Faaz17/nurdle-dna/jetson/README.md

# NurdleDNA — Jetson Nano Agent

Runs on the NVIDIA Jetson Nano. Handles AI vision, serial comms with the Arduino, and Firebase cloud publishing.

---

## 1. First-time setup

```bash
# Clone repo on Jetson
git clone https://github.com/Faaz17/nurdle-dna.git
cd nurdle-dna/jetson
```

### Jetson Nano (original — 4GB)
The standard Ultralytics/torch stack does NOT install cleanly on Jetson Nano.
Use the lightweight install instead:

```bash
pip3 install pyrebase4 pyserial opencv-python onnxruntime
```

The vision module will use the ONNX model if present (fast), or fall back
to the built-in OpenCV HSV detector (no model needed).

### Jetson Orin / desktop / cloud
```bash
pip3 install -r requirements.txt
```

---

## 2. Configure

Edit `config.py`:

| Setting | What to change |
|---|---|
| `SERIAL_PORT` | Run `ls /dev/tty*` before and after plugging in USB → find the new entry (usually `/dev/ttyUSB0` or `/dev/ttyACM0`) |
| `CAMERA_INDEX` | `0` for USB webcam; for CSI cam use the GStreamer string from Jetson camera docs |
| `YOLO_MODEL` | Path to your `.onnx` model. Set `None` to use OpenCV fallback |
| `FIREBASE_CONFIG` | Paste values from Firebase Console → Project Settings → General → Web app |

---

## 3. YOLOv8 model (optional but recommended)

**Option A — Use Roboflow pre-trained nurdle model (fastest)**
```bash
pip3 install roboflow
python3 -c "
from roboflow import Roboflow
rf = Roboflow(api_key='YOUR_ROBOFLOW_KEY')
project = rf.workspace().project('nurdle-microplastic')
model = project.version(1).model
model.download('yolov8')
"
# Then export to ONNX:
yolo export model=nurdle-microplastic.pt format=onnx
mv nurdle-microplastic.onnx models/nurdle-yolov8n.onnx
```

**Option B — Skip model, use OpenCV fallback**
Set `YOLO_MODEL = None` in `config.py`. The HSV colour detector works without any model file.

---

## 4. Run

```bash
python3 main.py
```

Press `Ctrl+C` to stop cleanly.

---

## 5. Auto-start on Jetson boot (systemd)

For the prototype enclosure (no keyboard / monitor attached during normal
operation), the agent should start automatically when the Jetson powers on.
A ready-to-use unit file is shipped at [`nurdle-agent.service`](nurdle-agent.service).

One-time install:

```bash
cd ~/nurdle-dna && git pull
sudo cp jetson/nurdle-agent.service /etc/systemd/system/
sudo systemctl daemon-reload
sudo systemctl enable --now nurdle-agent.service
```

Check it's running:

```bash
sudo systemctl status nurdle-agent.service
journalctl -u nurdle-agent -n 50    # last 50 log lines
```

The full guide — including diagnostics, what to expect at power-on, and how
to monitor status without a screen — is in
[INSTALL_AUTOSTART.md](INSTALL_AUTOSTART.md).

---

## 6. Data flow

```
Camera
  → vision.py (YOLOv8n / HSV)
      → count, confidence, state (CLEAR / WARN / CRIT)
          → serial_bridge.py → Arduino (JSON command)
          → cloud.py → Firebase /devices/NURDLE-001
                     → Firebase /events/{key}  (on ALARM)
Arduino
  → serial_bridge.py (JSON telemetry every 200 ms)
      → cloud.py (merged into Firebase payload)
```

---

## 7. Firebase database structure

```json
/devices/NURDLE-001 {
  "timestamp":     "2026-05-11T10:32:00Z",
  "device_id":     "NURDLE-001",
  "bay_id":        "BAY-1",
  "fsm_state":     "S3",
  "valve":         "CLOSED",
  "ldr":           642,
  "gas_ppm":       380,
  "load_g":        3.4,
  "density_index": 72,
  "status":        "ALARM",
  "ai_state":      "CRIT",
  "ai_count":      12,
  "ai_confidence": 0.87
}

/events/{push-key} {
  "timestamp":     "2026-05-11T10:32:00Z",
  "device_id":     "NURDLE-001",
  "type":          "ALARM",
  "fsm_state":     "S3",
  "density_index": 84,
  "gas_ppm":       380,
  "load_g":        3.4,
  "ai_count":      12
}
```
