Faaz17/nurdle-dna/Presentations/ICSIMA2026_Video_Package/ICSIMA2026_NurdleDNA_Video_Presentation.pptx

ICSIMA2026

NurdleDNA: An Edge-AI and Smart IoT Inline System for Source-Level Microplastic Detection

Faaz Ali Sayyed, Muhammad Haaziq, Daniel Joseph Koshy, Mohammed Abdul Rehman, Syed Hasan Ali, Razveen Kashif, and Mohd Fareq Abd Malek

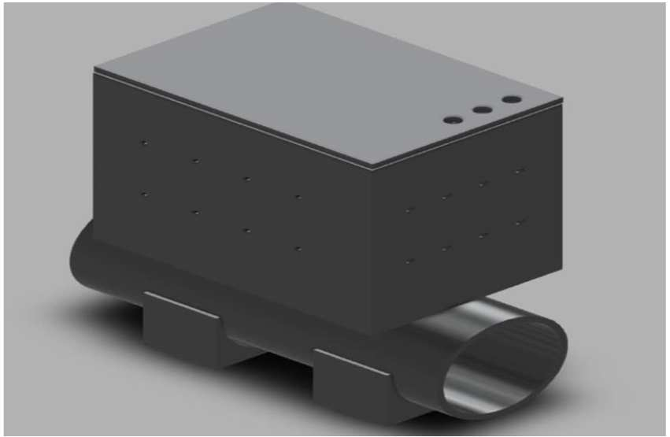
[picture p3: figure]
CAD rendering of the NurdleDNA inline device

University of Wollongong in Dubai

Backup presentation video: 12 minutes maximum, followed by live Q&A

ICSIMA2026 backup video | NurdleDNA

1 / 12

## Slide 2

Industrial nurdle leaks need source-level response

The problem is not only detecting pellets. It is intercepting them before they leave the discharge point.

3-5 mm

typical pre-production pellet size

Real time

required before downstream spread

Source level

where containment still works

Core gap

Existing approaches can often detect or document contamination, but they do not physically arrest the flow and preserve an audit trail at the source.

NurdleDNA targets that gap.

- Manual inspection and passive filters are too slow for active discharge streams
- Turbidity or particle counters confuse nurdles with bubbles, sand, and bio-particles
- Laboratory FTIR and Raman methods are accurate, but not inline containment systems
- Industrial drains may also carry VOC or hydrocarbon contamination

ICSIMA2026 backup video | NurdleDNA

2 / 12

## Slide 3

NurdleDNA closes the loop from detection to evidence

The system couples AI perception with deterministic actuation and cloud logging.

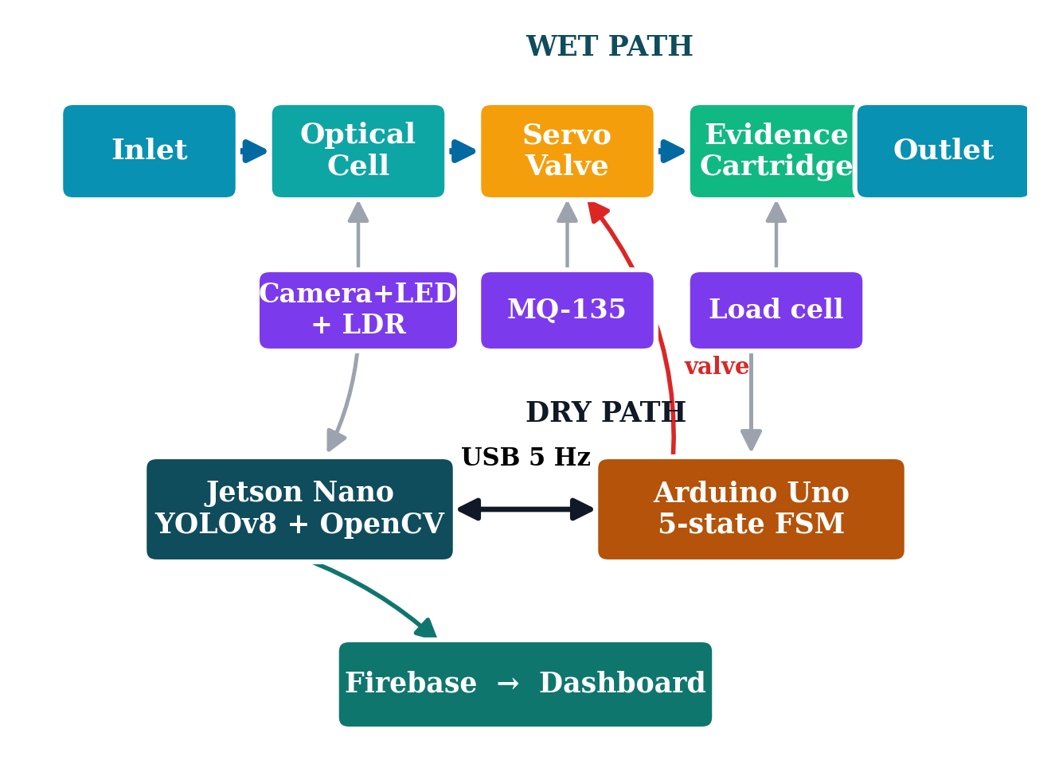
[picture p4: figure]
System architecture diagram showing wet and dry paths

Detect

Classify

Actuate

Capture

Log

- Camera and optical chamber detect candidate pellets
- LDR, MQ-135, and temporal logic validate the hazard
- Arduino FSM closes the servo pinch valve during alarm
- Load cell measures captured evidence while Firebase stores the event

ICSIMA2026 backup video | NurdleDNA

3 / 12

## Slide 4

The prototype separates probabilistic AI from safety control

Jetson handles inference and cloud publishing; Arduino owns deterministic containment.

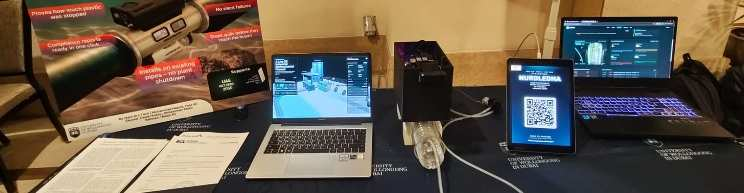
[picture p5: figure]
Assembled NurdleDNA prototype with supporting visualizations

Jetson Nano

- YOLOv8n and OpenCV
- JPEG evidence frame
- Firebase publish
- Dashboard feed

Arduino Uno

- LDR and MQ-135
- Load cell via HX711
- Moore FSM
- Servo pinch valve

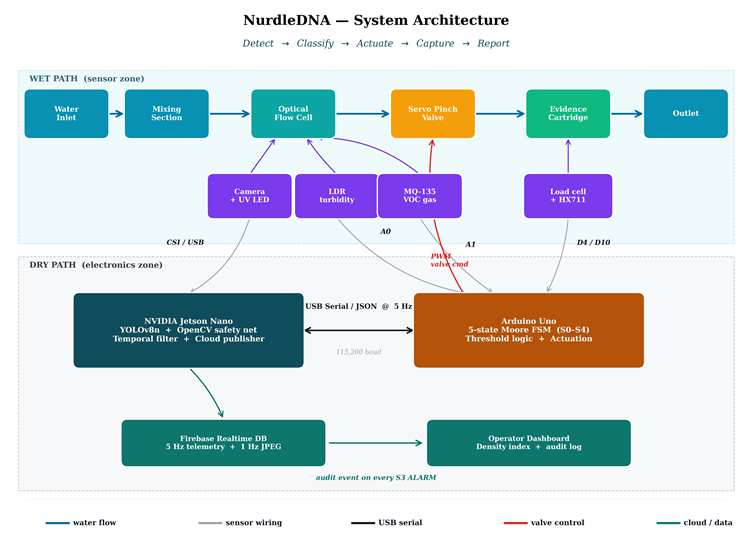
[picture p6: figure]
Full system architecture from the accepted paper

Design intent: if AI confidence is uncertain or cloud connectivity fails, physical containment still remains under deterministic local control.

ICSIMA2026 backup video | NurdleDNA

4 / 12

## Slide 5

The vision model is useful, but it is not trusted alone

The paper treats YOLO as one probabilistic signal inside a wider sensor-fusion decision.

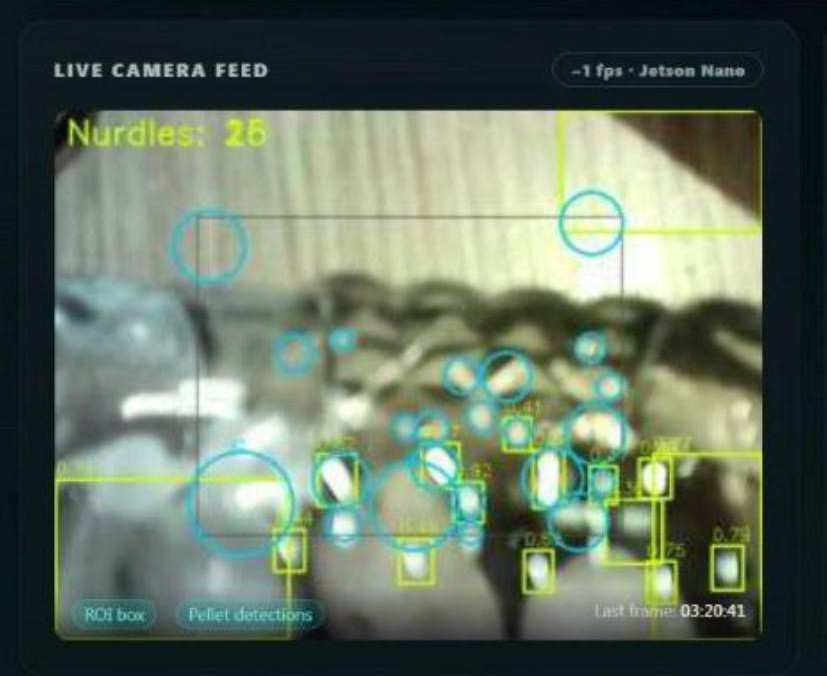
[picture p7: figure]
YOLOv8n detection output in the optical flow cell
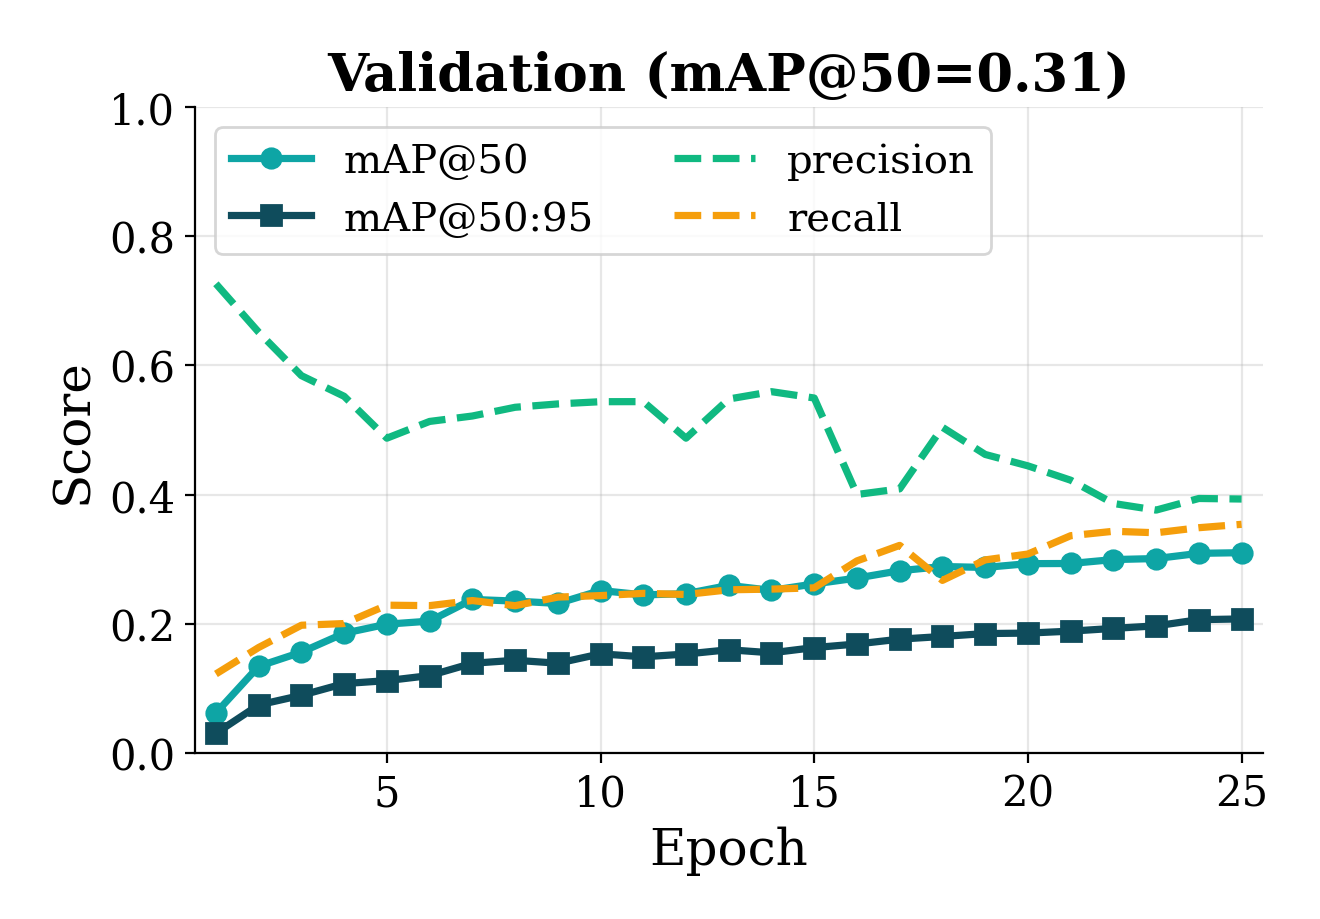
[picture p8: figure]
YOLOv8n validation metrics over 25 epochs
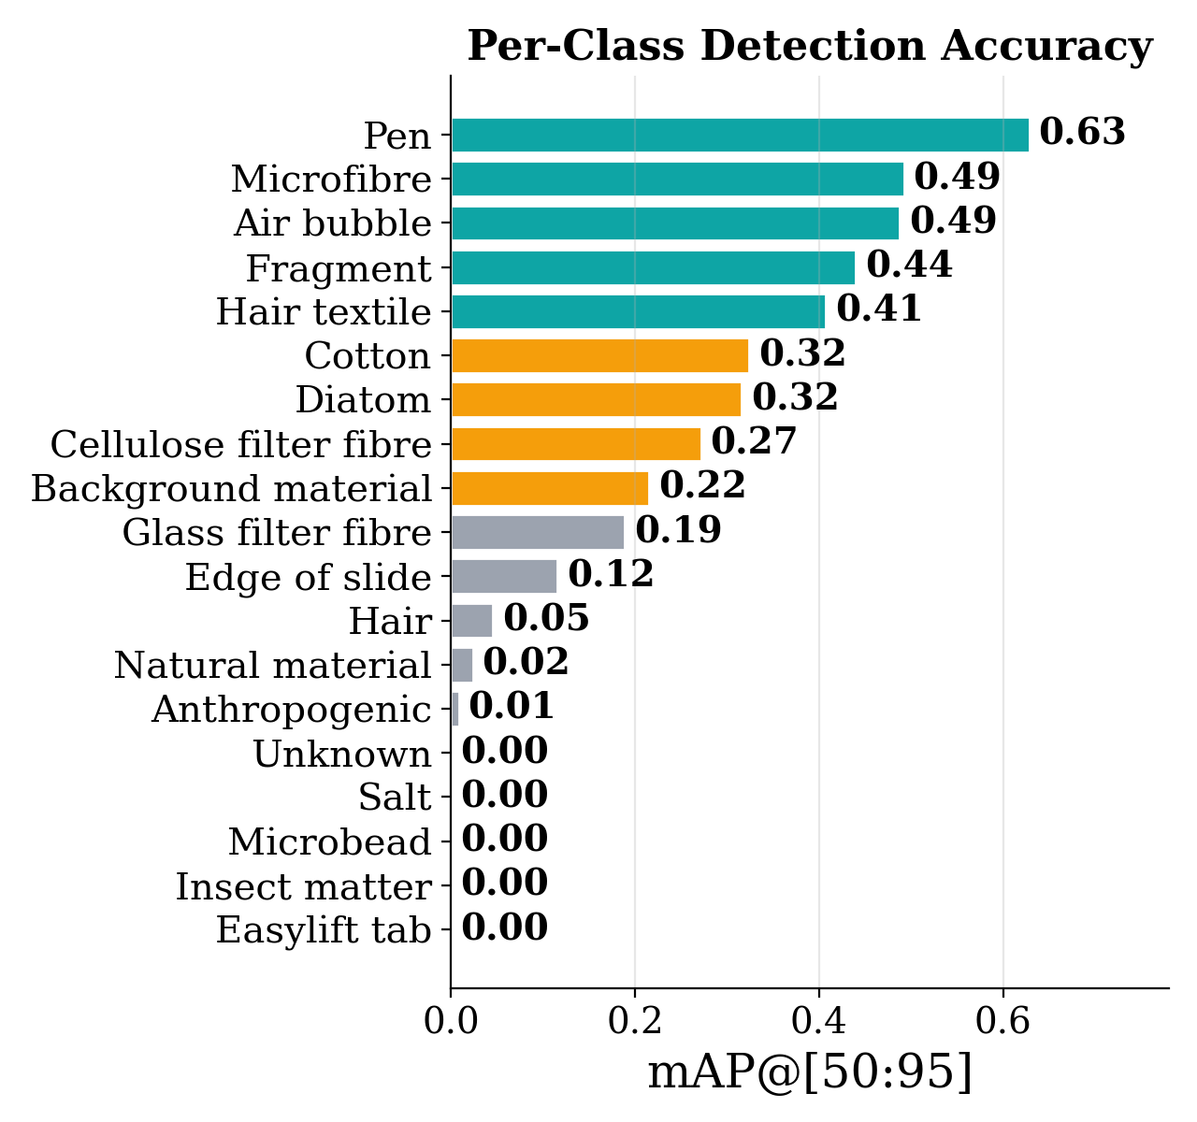
[picture p9: figure]
Per-class detection accuracy chart

0.31

overall mAP@50 on the public validation split

25

training epochs on YOLOv8n

19

public dataset classes, with severe imbalance

Interpretation: the model can detect pellets and visual candidates, but bubbles, glare, and dataset imbalance make temporal and sensor confirmation necessary.

ICSIMA2026 backup video | NurdleDNA

5 / 12

## Slide 6

Multi-sensor confirmation suppresses false alarms

The alarm decision requires persistence across optical, gas, and AI-derived evidence.

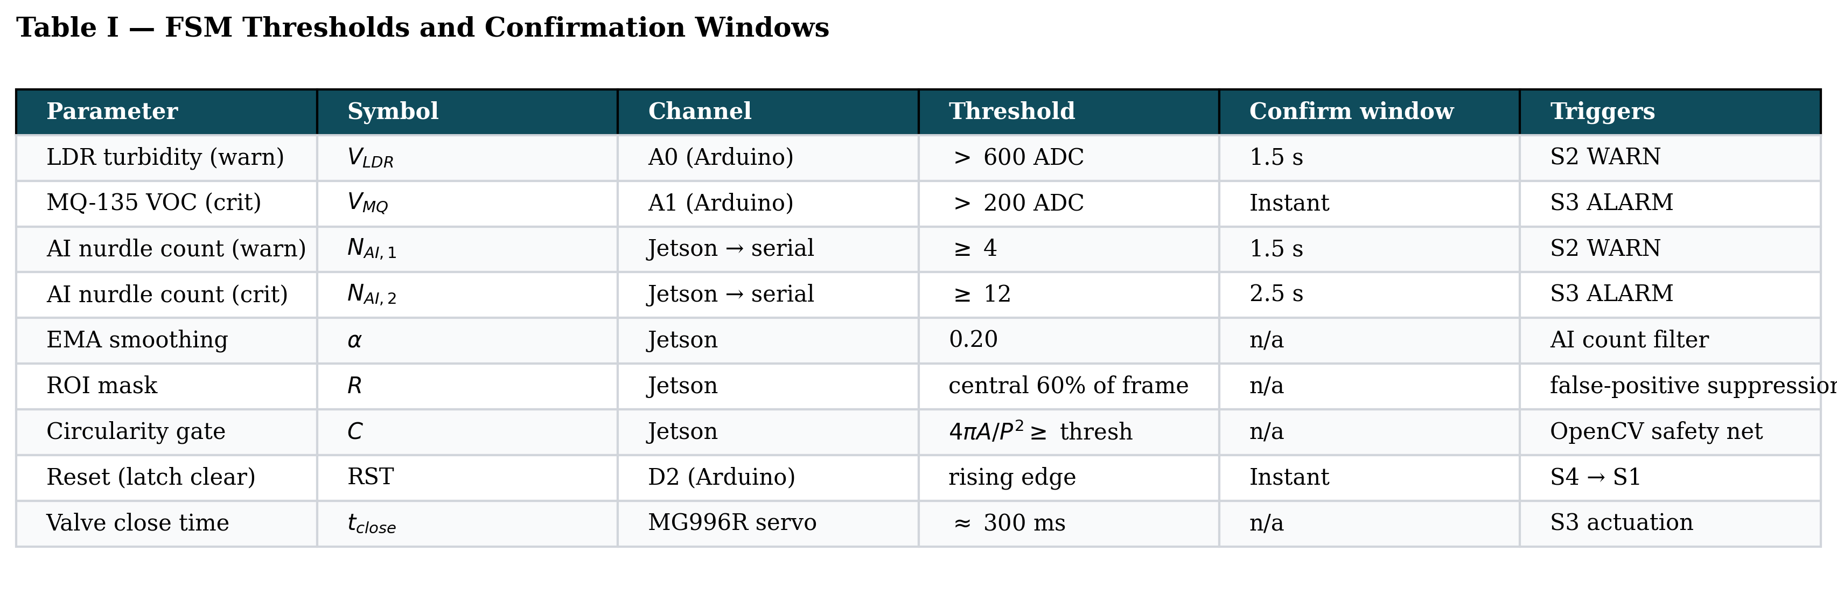
[picture p10: figure]
FSM thresholds and confirmation windows table

Filtering strategy

- Region-of-interest masks the active frame
- Circularity filter rejects linear reflections
- EMA smoothing reduces sensor spikes
- Confirmation timers prevent single-frame alarms

Bench false-positive tests produced no false S3 alarms before contamination was introduced.

- LDR warning threshold: above 600 ADC
- MQ-135 critical threshold: above 200 ADC
- AI warning: count >= 4 for 1.5 s
- AI critical: count >= 12 for 2.5 s

ICSIMA2026 backup video | NurdleDNA

6 / 12

## Slide 7

The finite-state machine makes containment deterministic

S3 alarm is latched and can only clear through an operator reset.

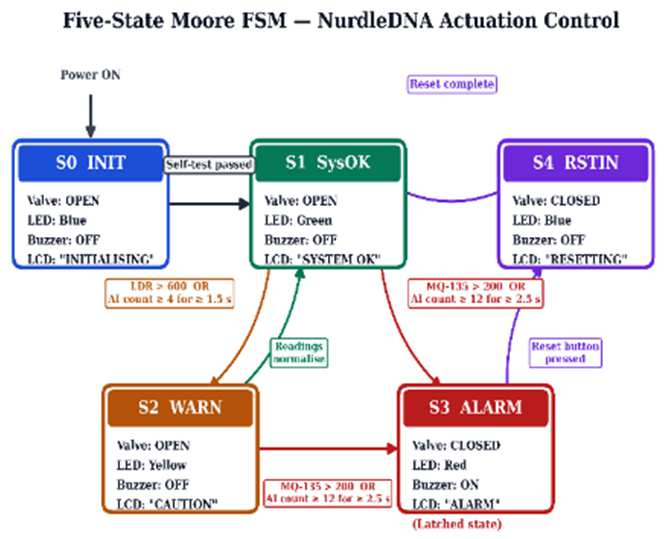
[picture p11: figure]
Five-state Moore finite-state machine for NurdleDNA actuation

S1 opens the valve and reports safe operation.

Normal

S2 keeps flow open while evidence is confirmed.

Warning

S3 closes the valve, turns on the alarm, and remains latched until reset.

Alarm

ICSIMA2026 backup video | NurdleDNA

7 / 12

## Slide 8

The response is dominated by confirmation, not actuation

The system waits long enough to avoid false alarms, then closes the valve quickly.

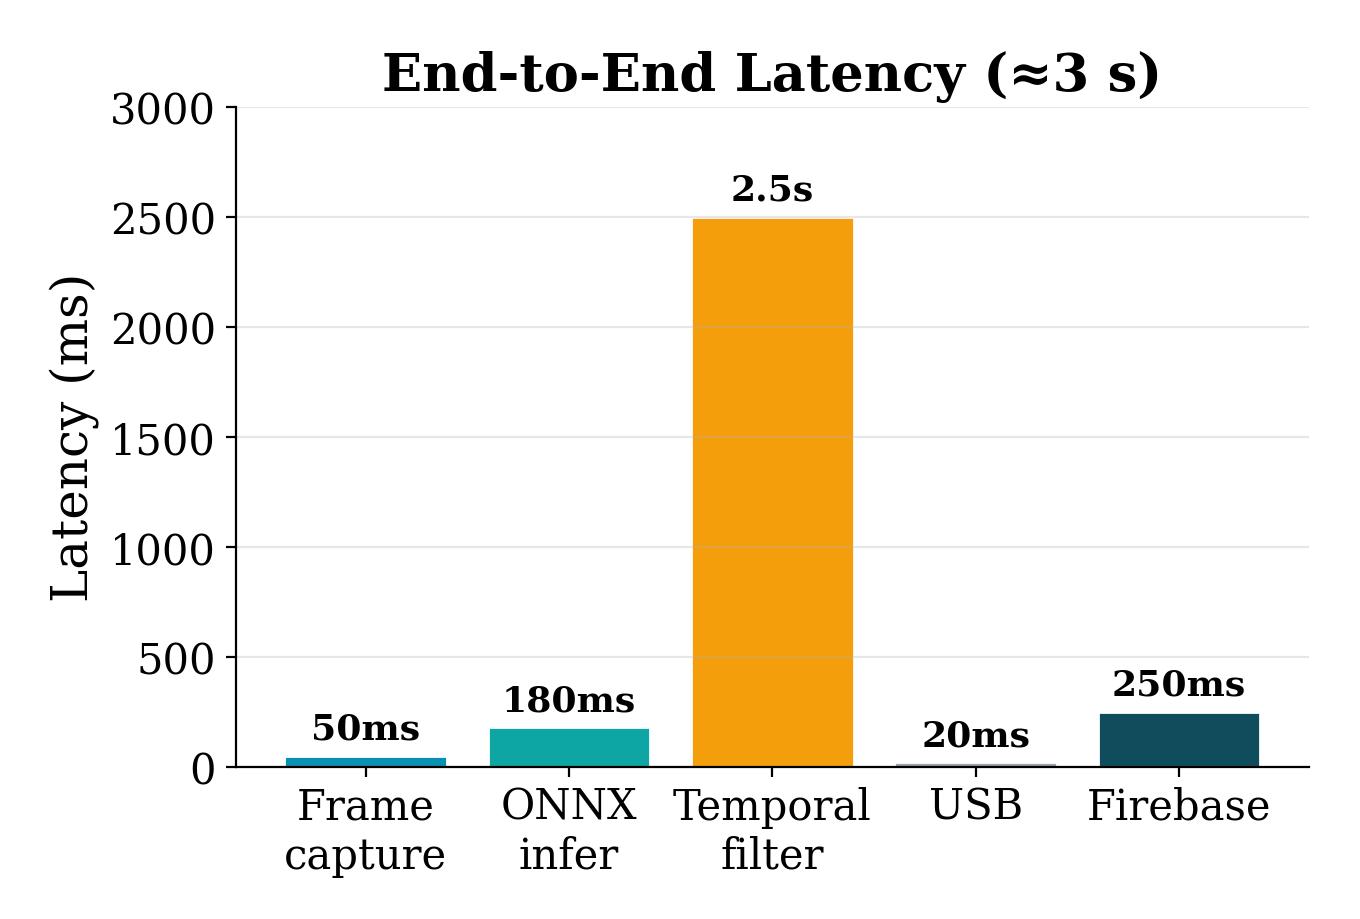
[picture p12: figure]
End-to-end latency breakdown
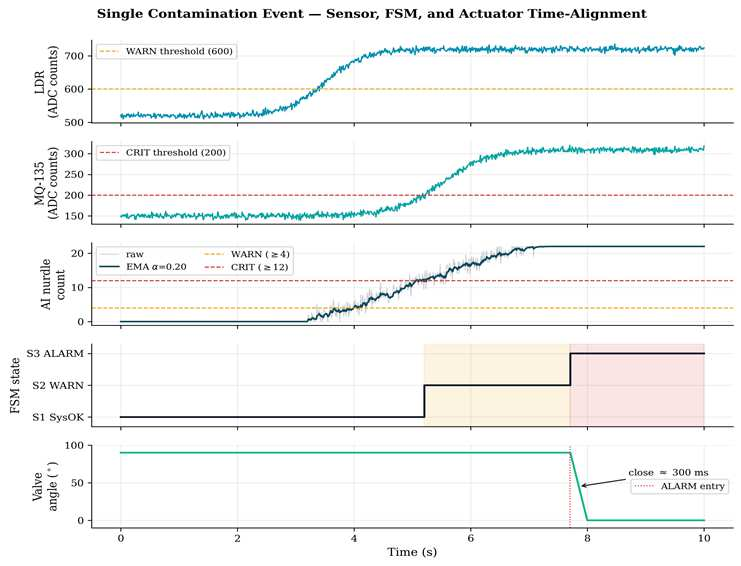
[picture p13: figure]
Time-aligned event trace showing sensor, FSM, and actuator behavior

The latency trade-off is intentional: a shorter window would respond faster, but would increase false alarms in bubbles, glare, and turbulent flow.

3.0 s

average end-to-end alarm response

2.5 s

temporal confirmation window

300 ms

valve seated after S3 activation

ICSIMA2026 backup video | NurdleDNA

8 / 12

## Slide 9

Each alarm creates physical and digital evidence

The system does not just signal a hazard; it preserves data that can support source-level accountability.

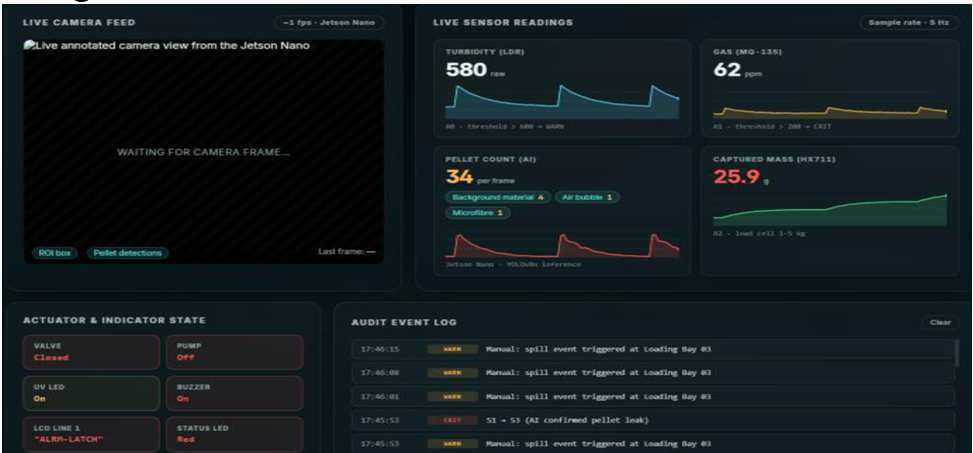
[picture p14: figure]
Firebase-backed dashboard during an active alarm event
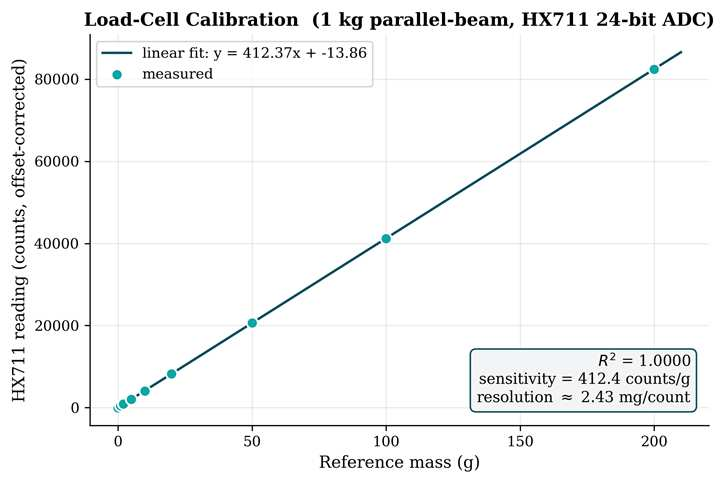
[picture p15: figure]
Load-cell calibration plot

- Evidence cartridge mass is recorded through HX711 calibration
- Cloud packets include state, sensor values, classified source, and valve state
- Dashboard provides a remote audit view during S3 alarm events

R2=1

load-cell calibration linearity

5 Hz

sensor recording and telemetry cadence

3 data

frame, captured mass, and VOC log

ICSIMA2026 backup video | NurdleDNA

9 / 12

## Slide 10

The contribution is containment plus auditability

Compared with conventional methods, NurdleDNA combines field response with traceable evidence.

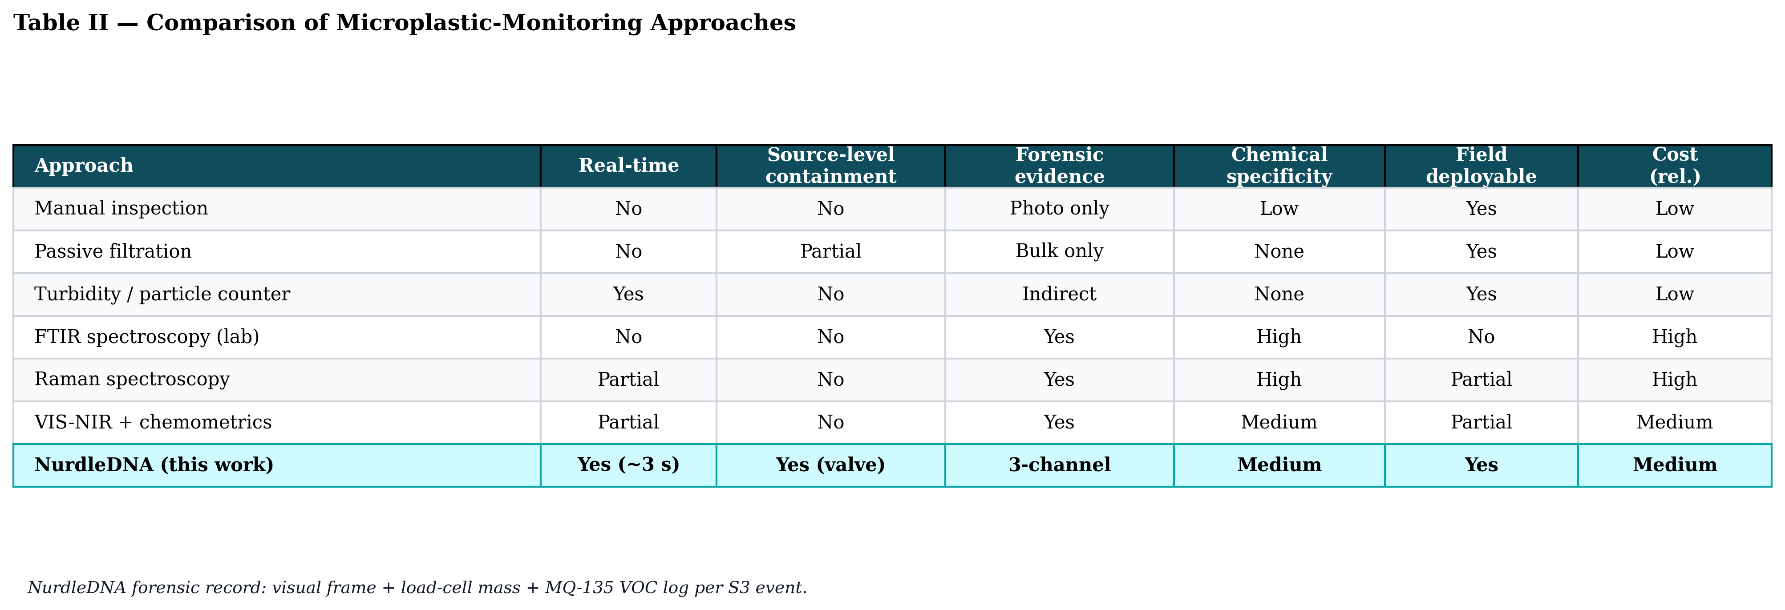
[picture p16: figure]
Comparison table of NurdleDNA with conventional microplastic-monitoring approaches

What changes

- Real-time source-level containment
- Physical capture, not only detection
- Cloud audit trail tied to each alarm

Yes

real-time response

Valve

source-level containment

Field

deployable bench prototype

The table's point is not that NurdleDNA replaces laboratory chemistry. It fills the operational gap between industrial discharge and later laboratory confirmation.

ICSIMA2026 backup video | NurdleDNA

10 / 12

## Slide 11

The next step is field hardening and better classification

The accepted paper is honest about limits and turns them into a roadmap.

Field hardening

IP-rated enclosure, multi-bay deployment, SCADA compatibility, and quantified maintenance intervals.

1

Model improvement

Curated weathered-nurdle dataset, class balancing, and YOLOv8s/m on Jetson Orin Nano.

2

Polymer ID

Miniature Raman or VIS-NIR sensing at the evidence cartridge to complete the NurdleDNA paradigm.

3

The roadmap preserves the architecture: detect locally, contain physically, and log evidence in a way that scales from one bay to many.

ICSIMA2026 backup video | NurdleDNA

11 / 12

## Slide 12

NurdleDNA turns microplastic monitoring into a closed-loop response system.

Detect

AI vision and sensor fusion identify a persistent hazard.

Contain

A deterministic Arduino FSM closes the physical flow path.

Prove

Captured mass, frames, and cloud logs create an audit trail.

Thank you. I am happy to take questions.

ICSIMA2026 backup video | NurdleDNA

12 / 12
