Faaz17/nurdle-dna/Posters/qr-poster.html

University of
Wollongong
in Dubai

ECTE 250 · Team 2 · Arc Tech

Presenting

NURDLEDNA

Inline IoT detection of microplastic pellets in oil pipelines & industrial water

Scan to explore NurdleDNA

Scan to exploreLive dashboard · 3D twin · website · the team

“Watch every stream, all the time.”
