Faaz17/nurdle-dna/Paper Figures/fig8_fsm_diagram.png

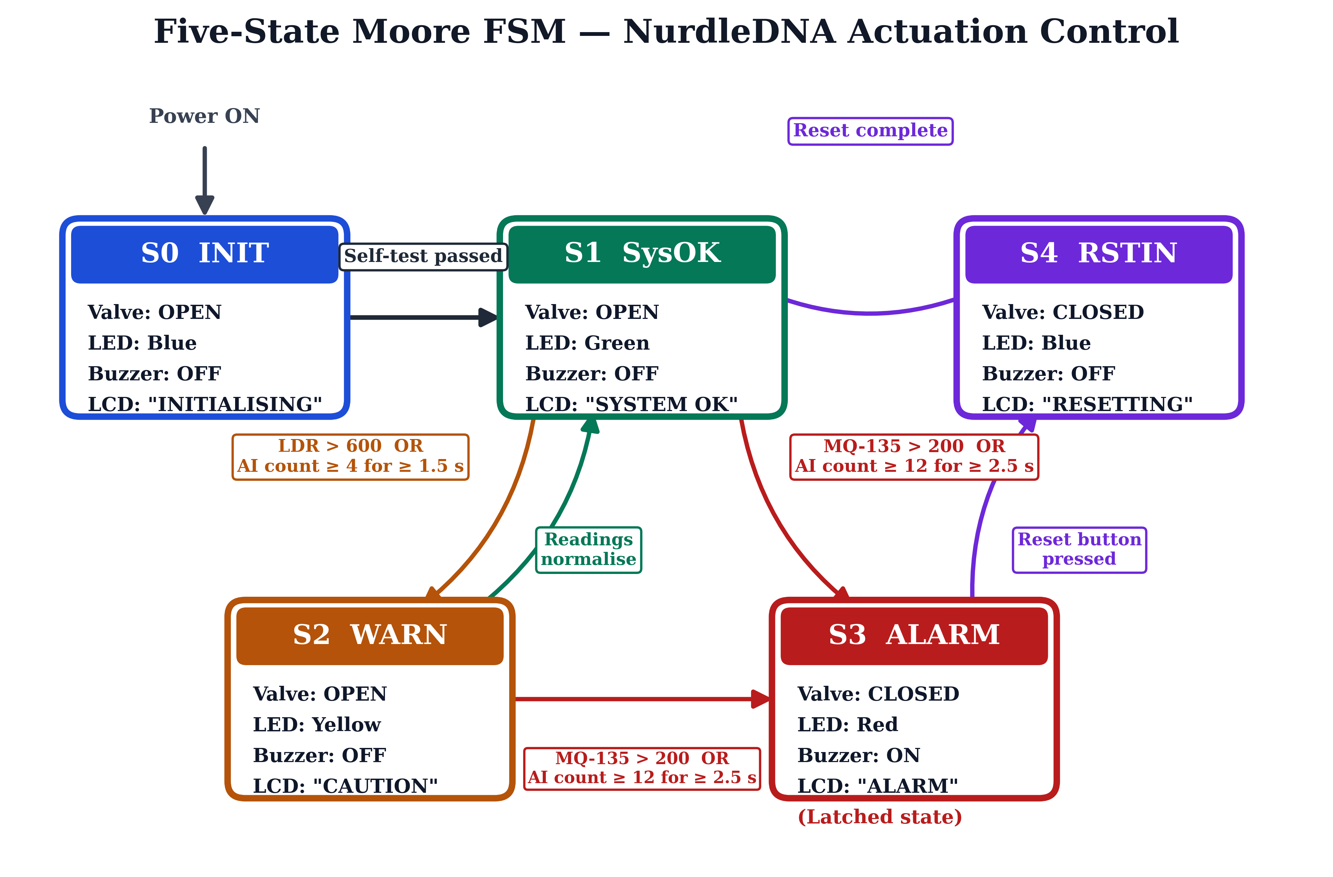
Paper Figures/fig8_fsm_diagram.png
