Faaz17/nurdle-dna/Paper Figures/real_run/BoxF1_curve.png

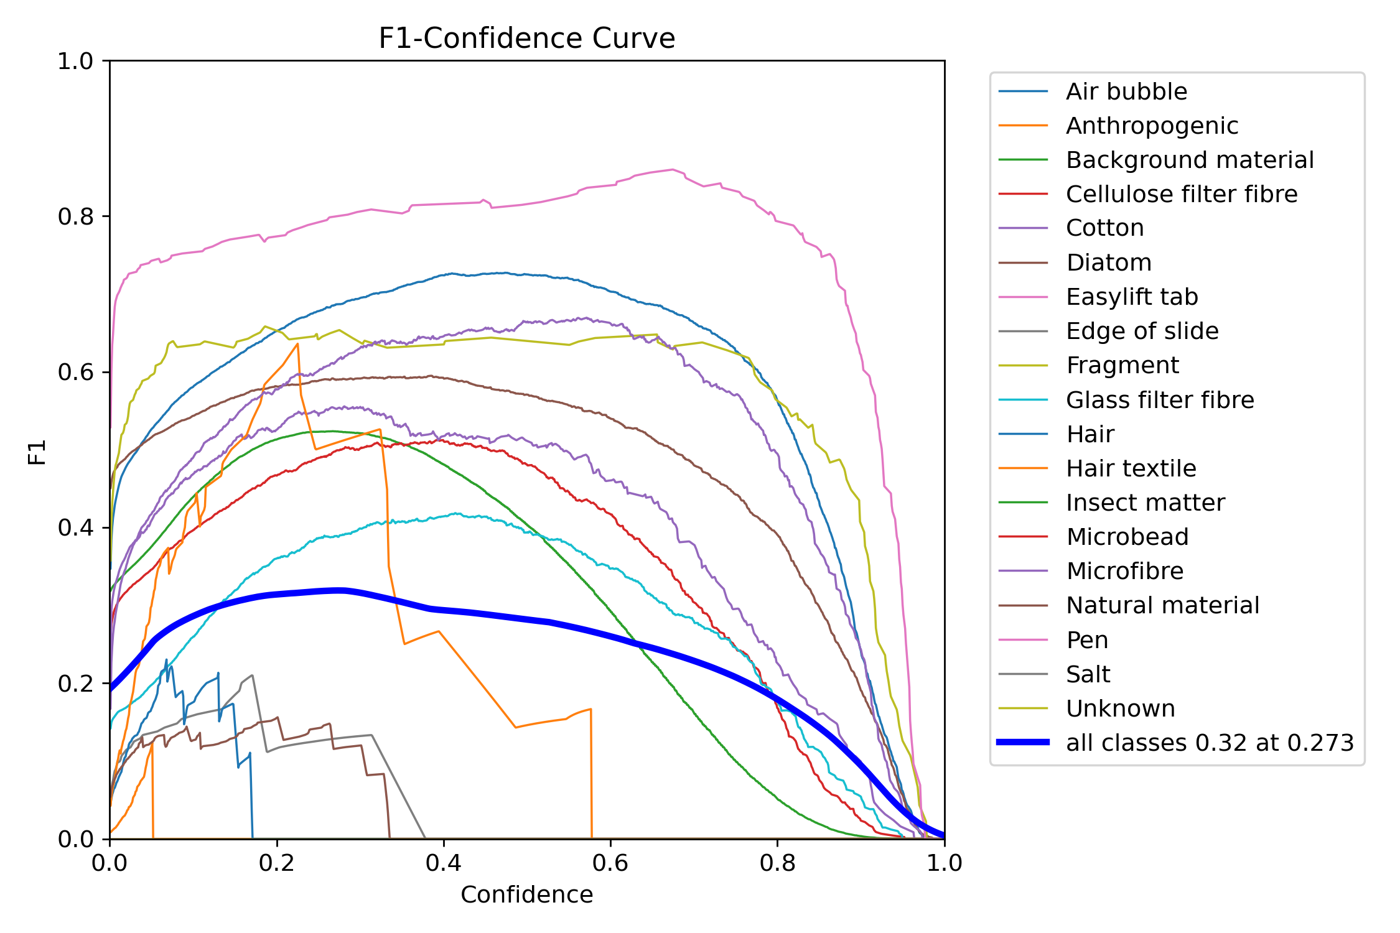
Paper Figures/real_run/BoxF1_curve.png
