Faaz17/nurdle-dna/Paper Figures/real_run/BoxP_curve.png

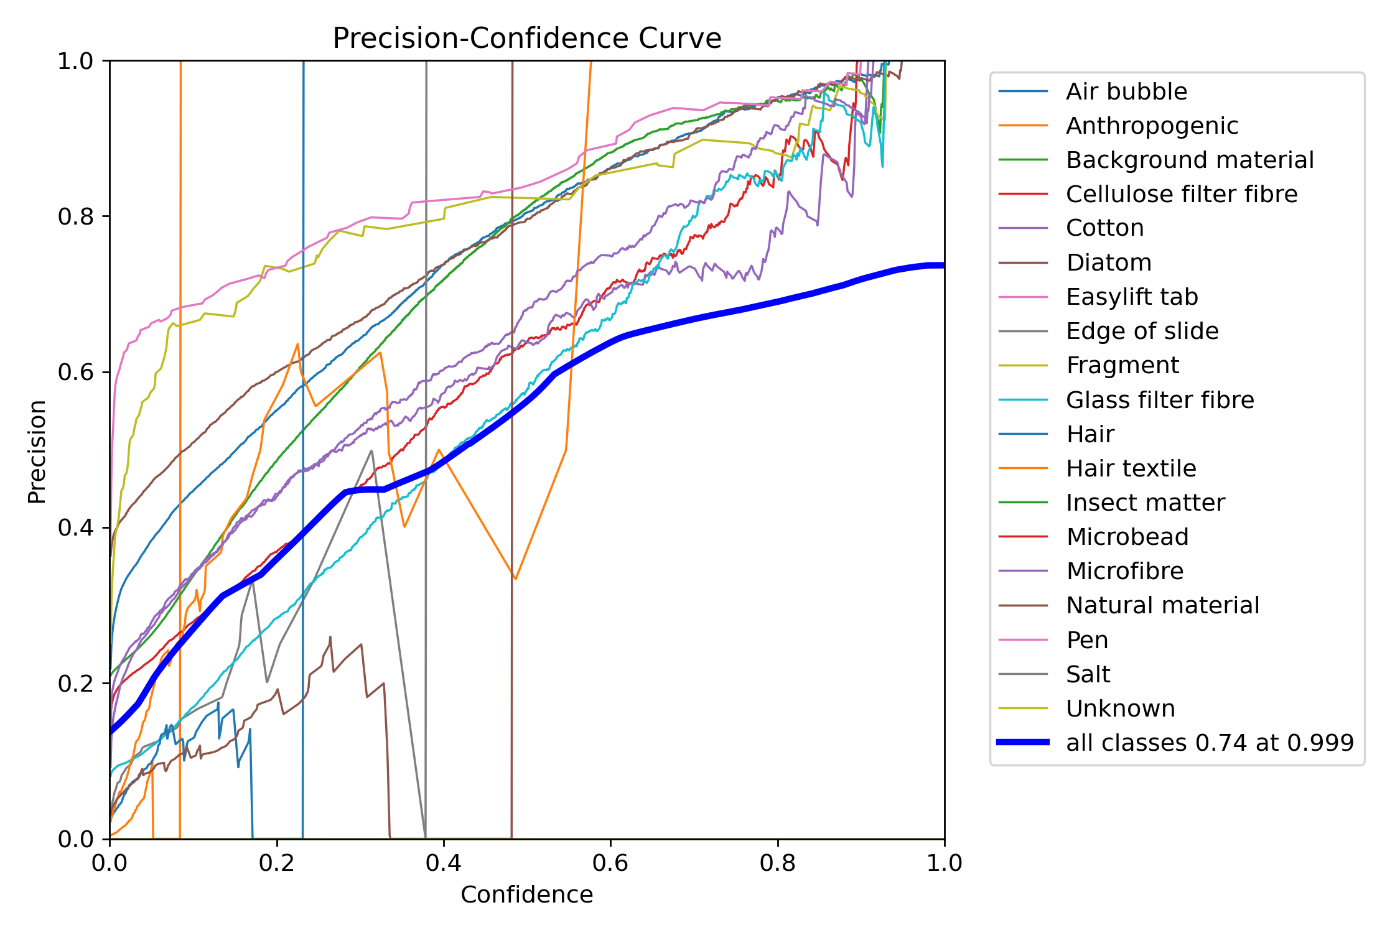
Paper Figures/real_run/BoxP_curve.png
