Faaz17/nurdle-dna/Paper Figures/real_run/BoxPR_curve.png

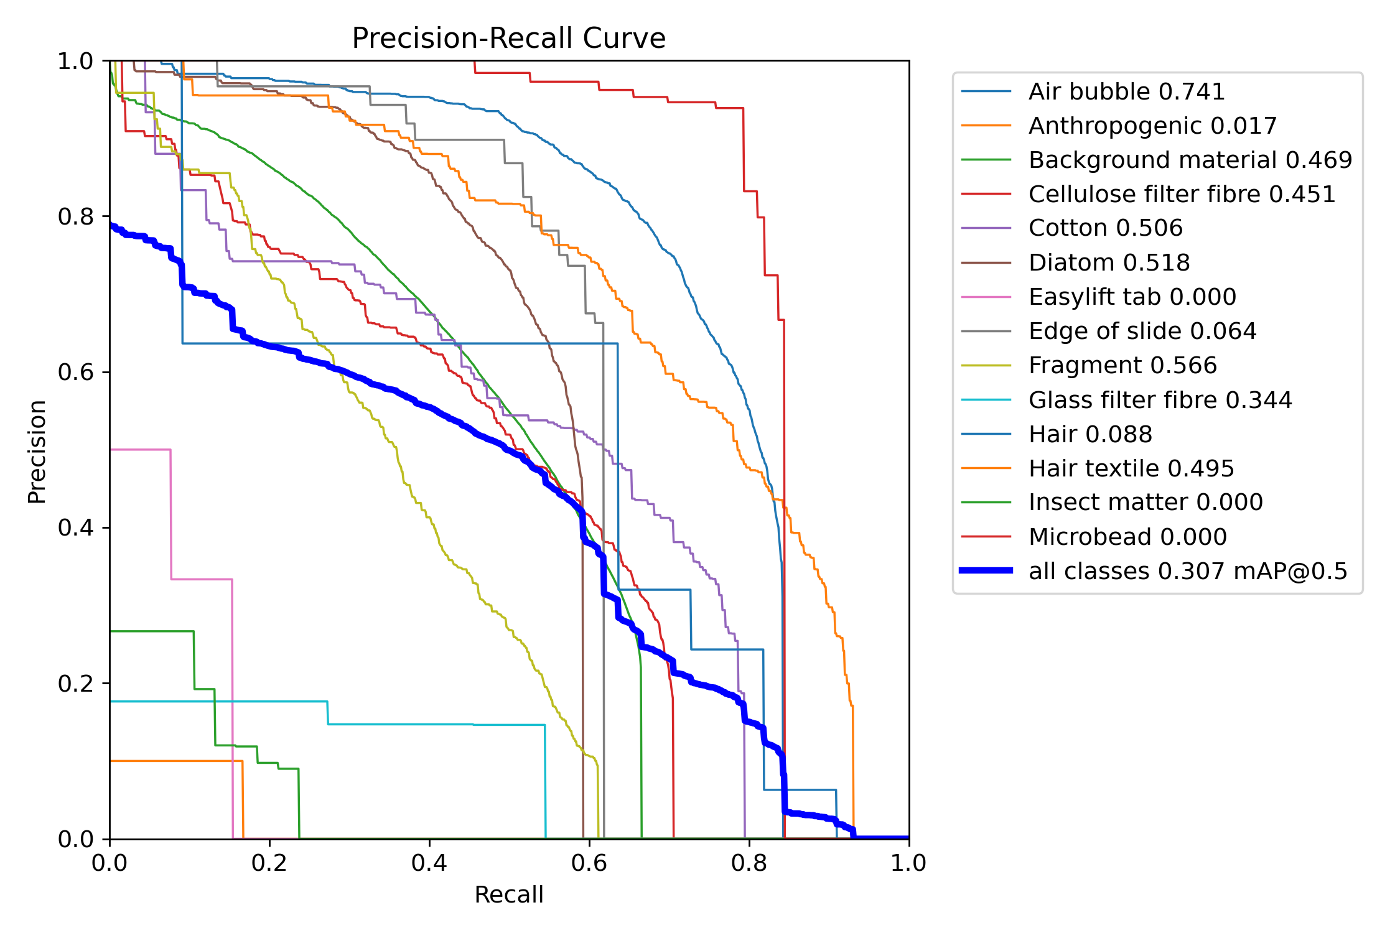
Paper Figures/real_run/BoxPR_curve.png
