Faaz17/nurdle-dna/Paper Figures/real_run/BoxR_curve.png

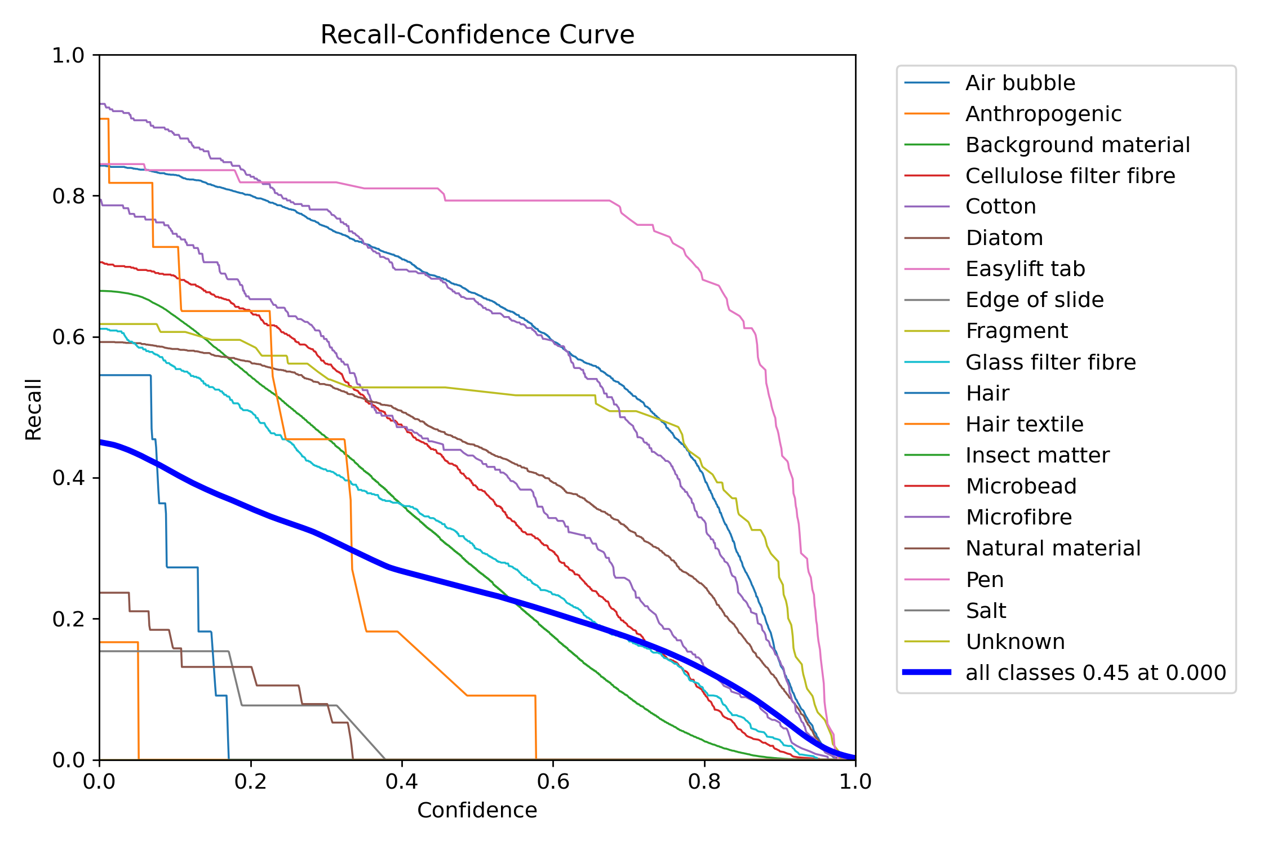
Paper Figures/real_run/BoxR_curve.png
