Faaz17/nurdle-dna/Paper Figures/real_run/confusion_matrix.png

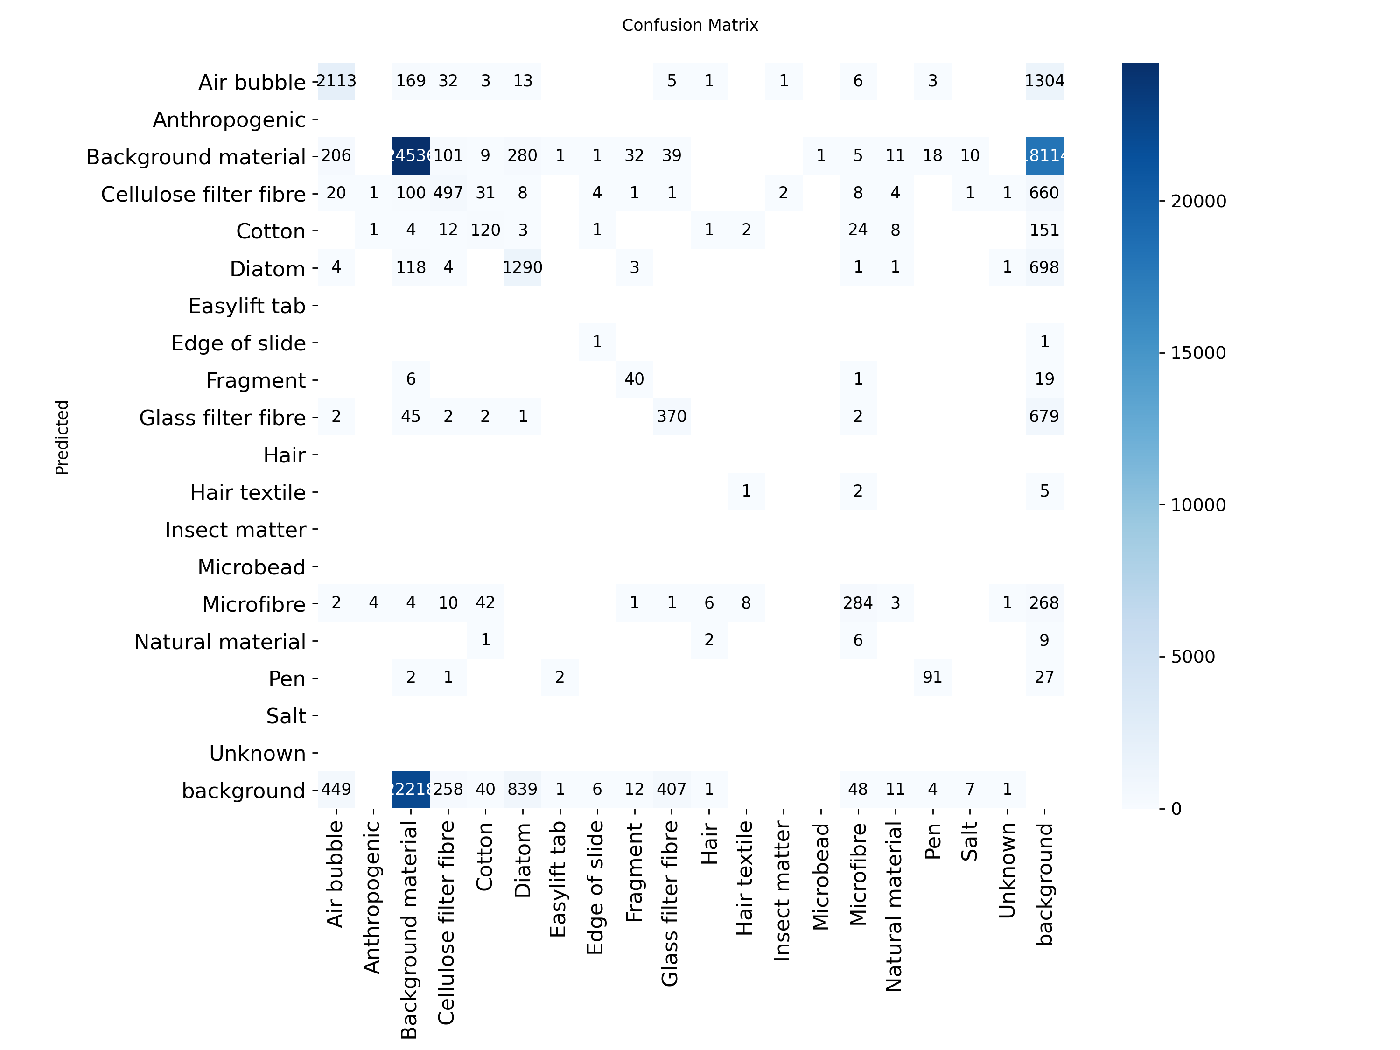
Paper Figures/real_run/confusion_matrix.png
