Faaz17/nurdle-dna/Paper Figures/real_run/confusion_matrix_normalized.png

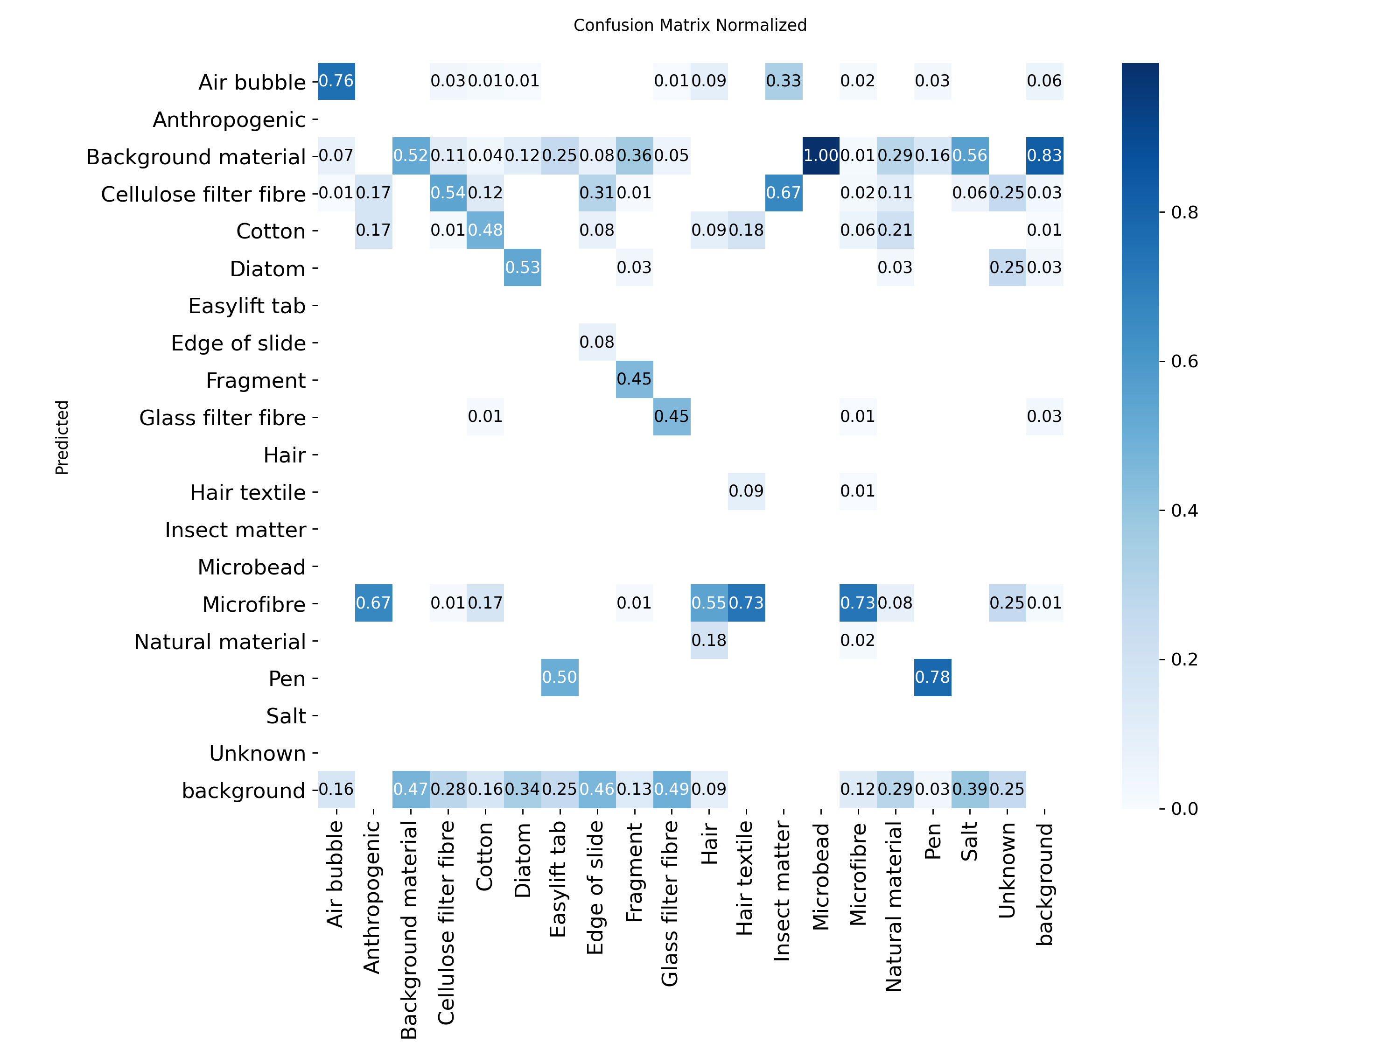
Paper Figures/real_run/confusion_matrix_normalized.png
