Faaz17/nurdle-dna/Paper Figures/real_run/labels.jpg

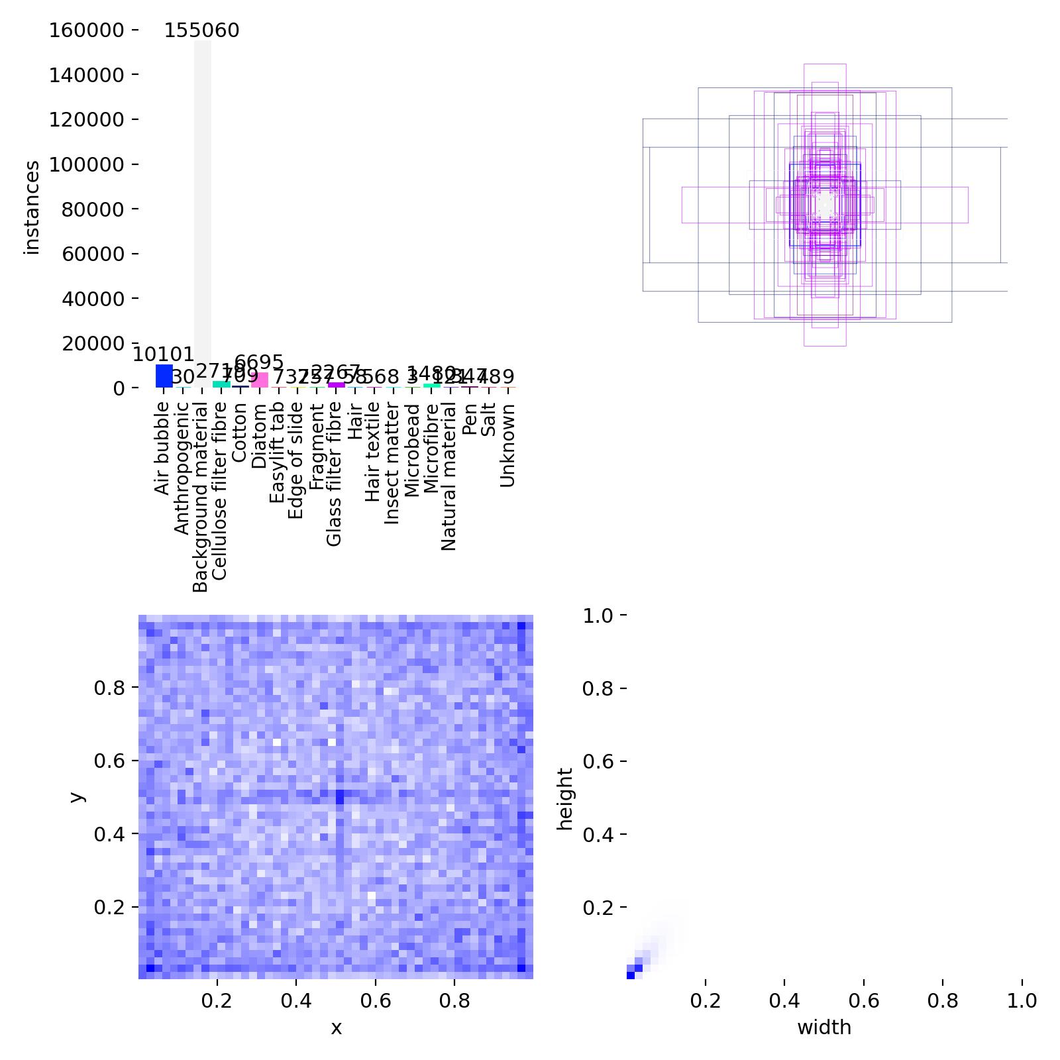
Paper Figures/real_run/labels.jpg
