Faaz17/nurdle-dna/Paper Figures/real_run/train_batch0.jpg

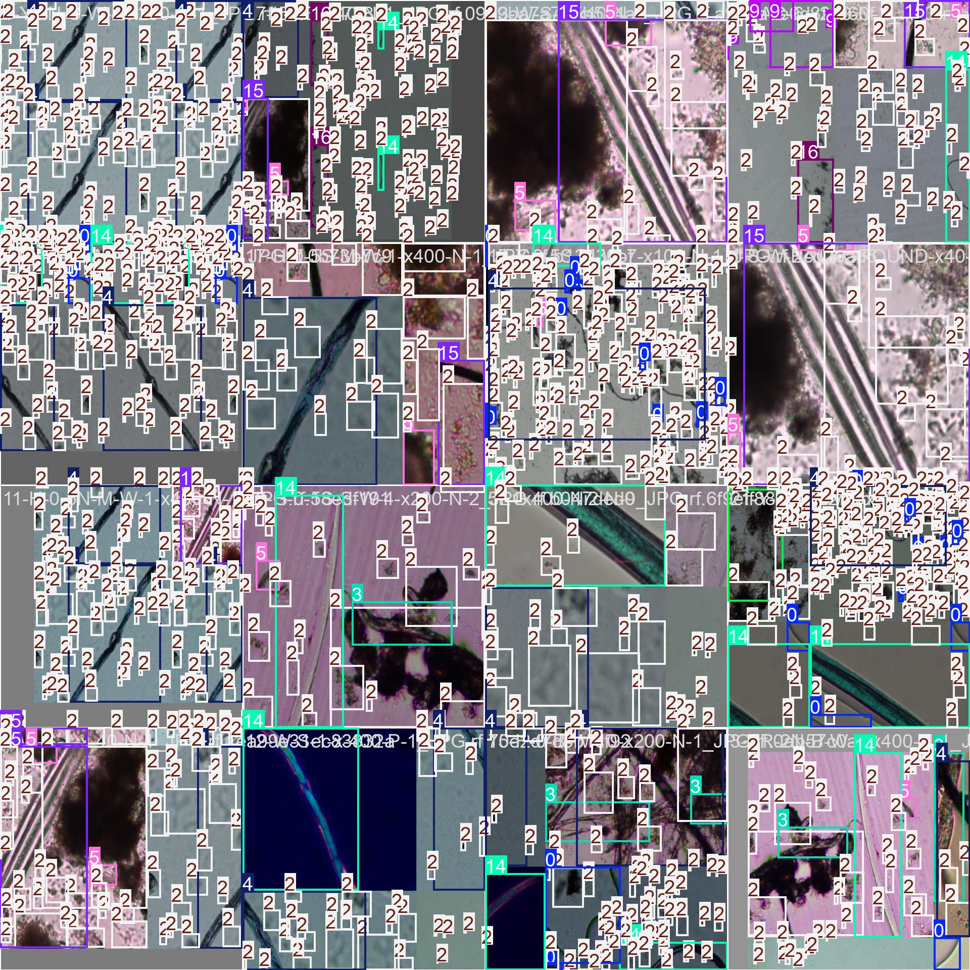
Paper Figures/real_run/train_batch0.jpg
