Faaz17/nurdle-dna/Paper Figures/real_run/train_batch2.jpg

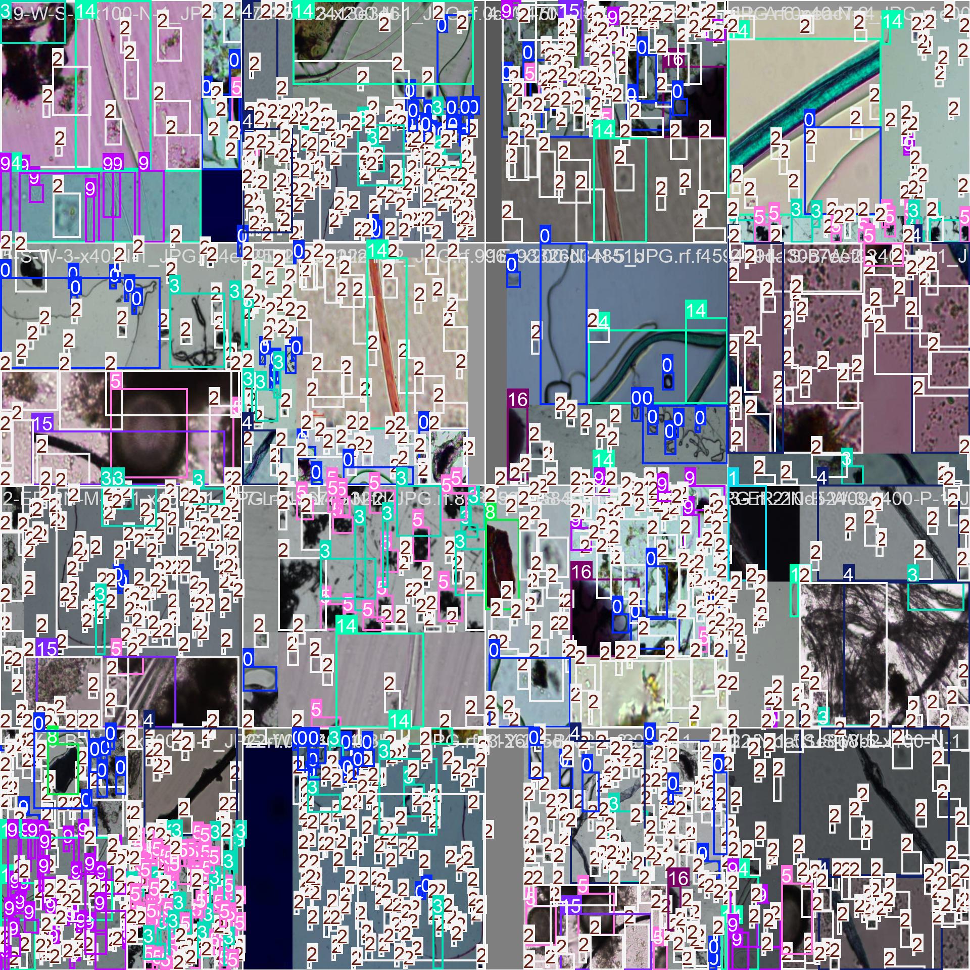
Paper Figures/real_run/train_batch2.jpg
