Faaz17/nurdle-dna/Paper Figures/real_run/val_batch0_labels.jpg

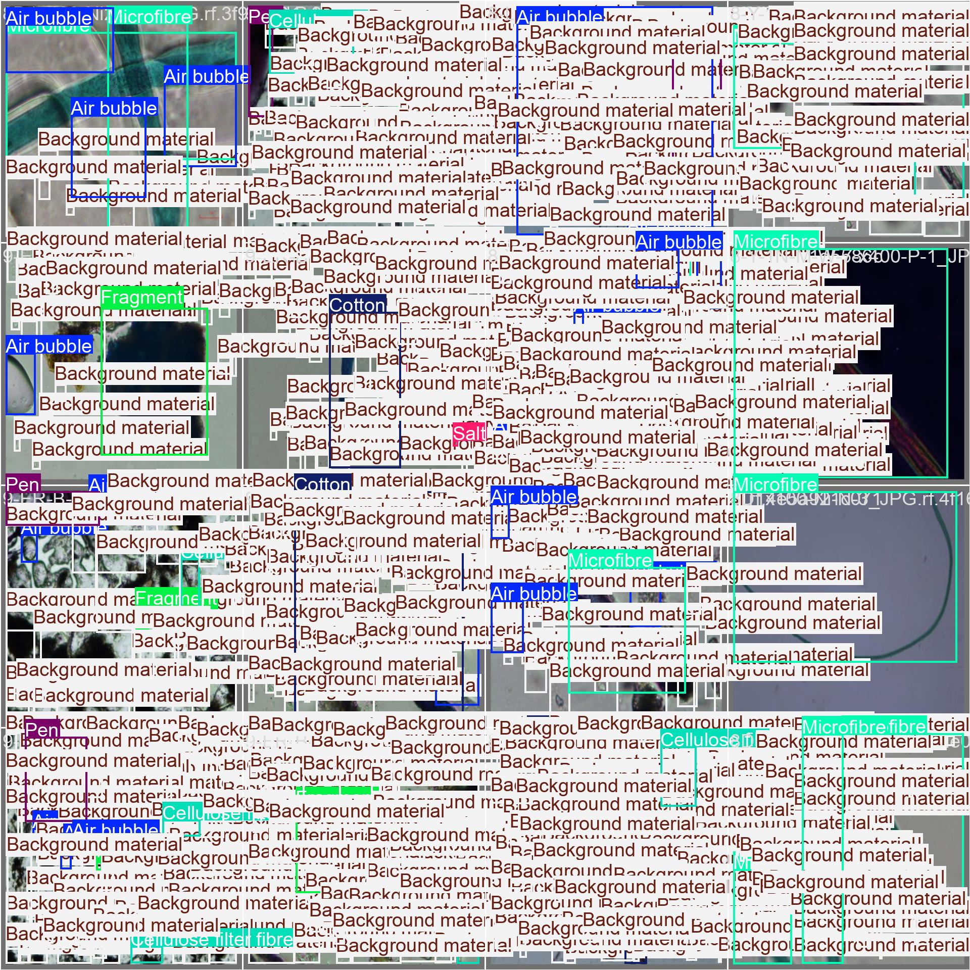
Paper Figures/real_run/val_batch0_labels.jpg
