Faaz17/nurdle-dna/Paper Figures/real_run/val_batch0_pred.jpg

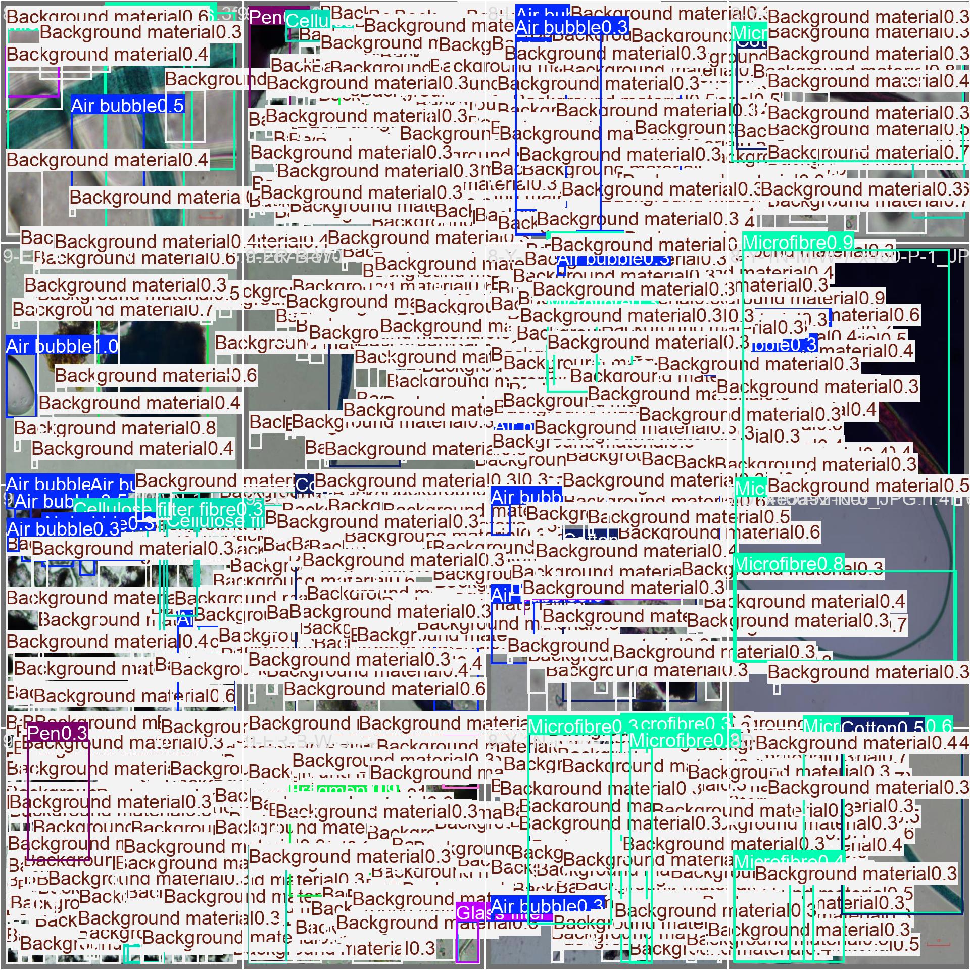
Paper Figures/real_run/val_batch0_pred.jpg
