Faaz17/nurdle-dna/Posters/nurdle-dna-qr-poster.png

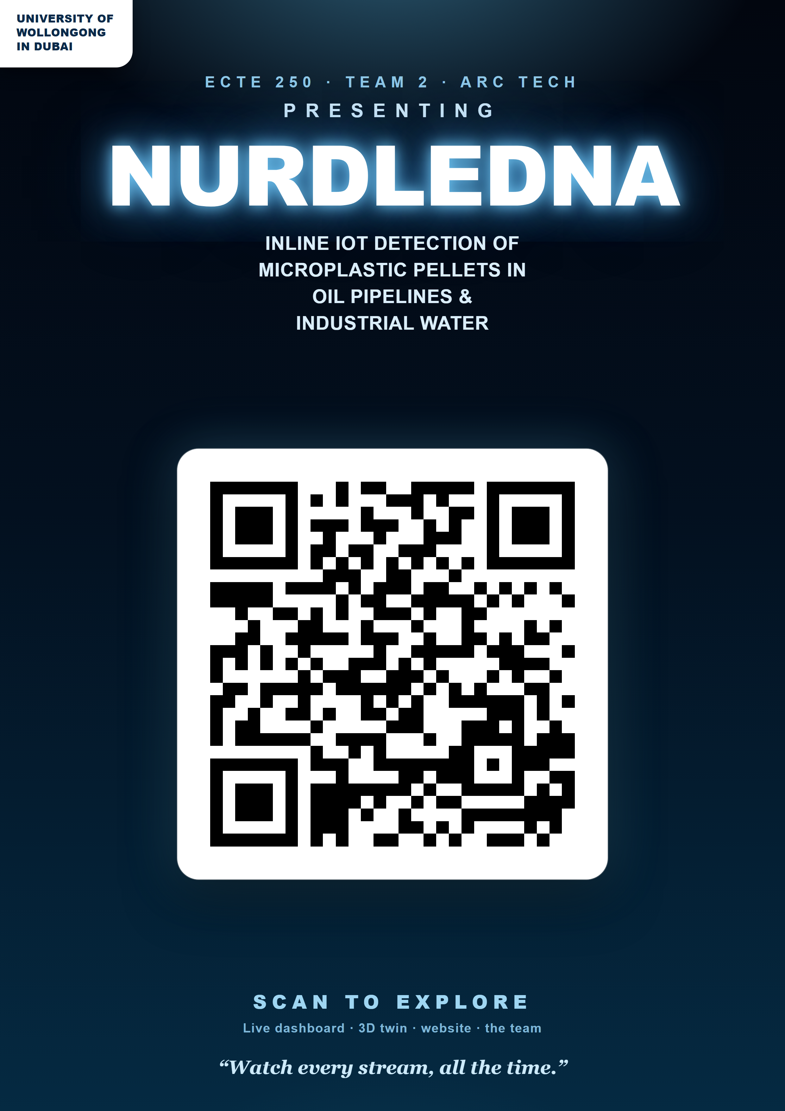
Posters/nurdle-dna-qr-poster.png
