Faaz17/nurdle-dna/Posters/nurdle-dna-qr.png

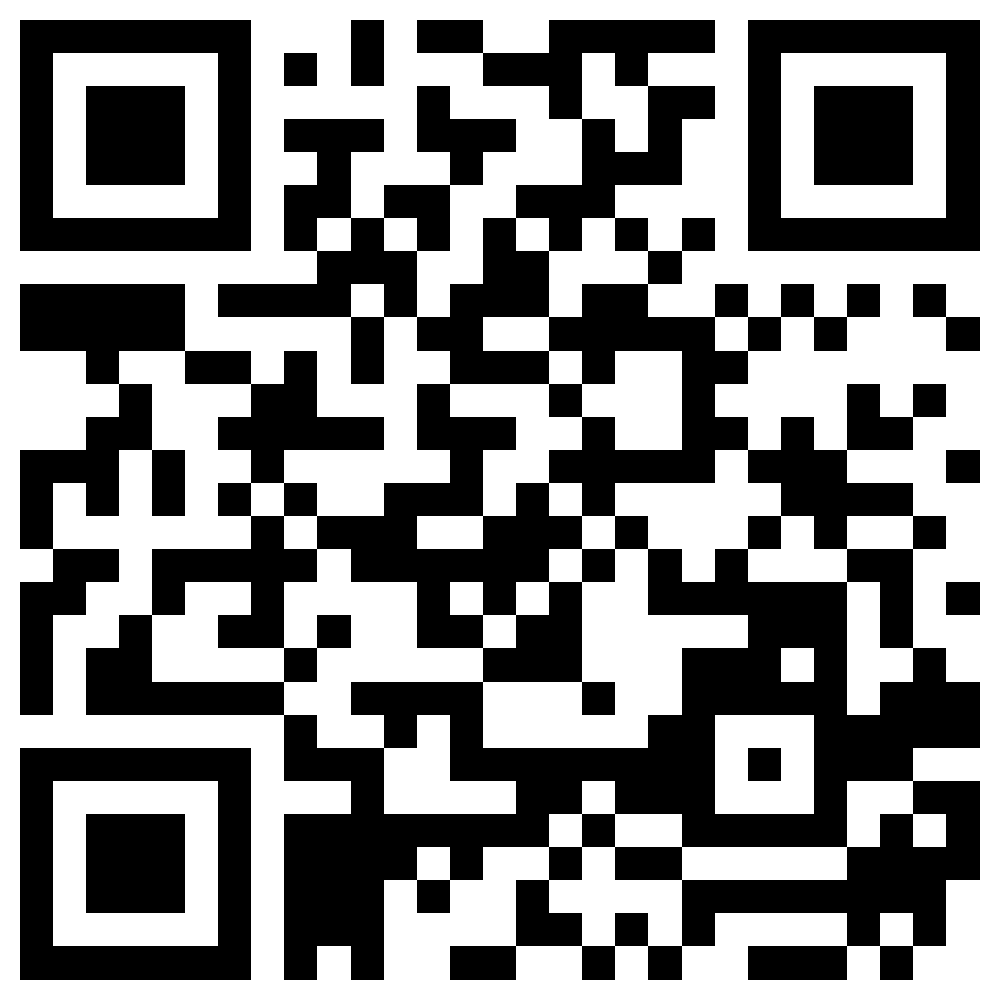
Posters/nurdle-dna-qr.png
