Faaz17/nurdle-dna/Presentations/ICSIMA2026_Video_Package/preview/Slide1.PNG

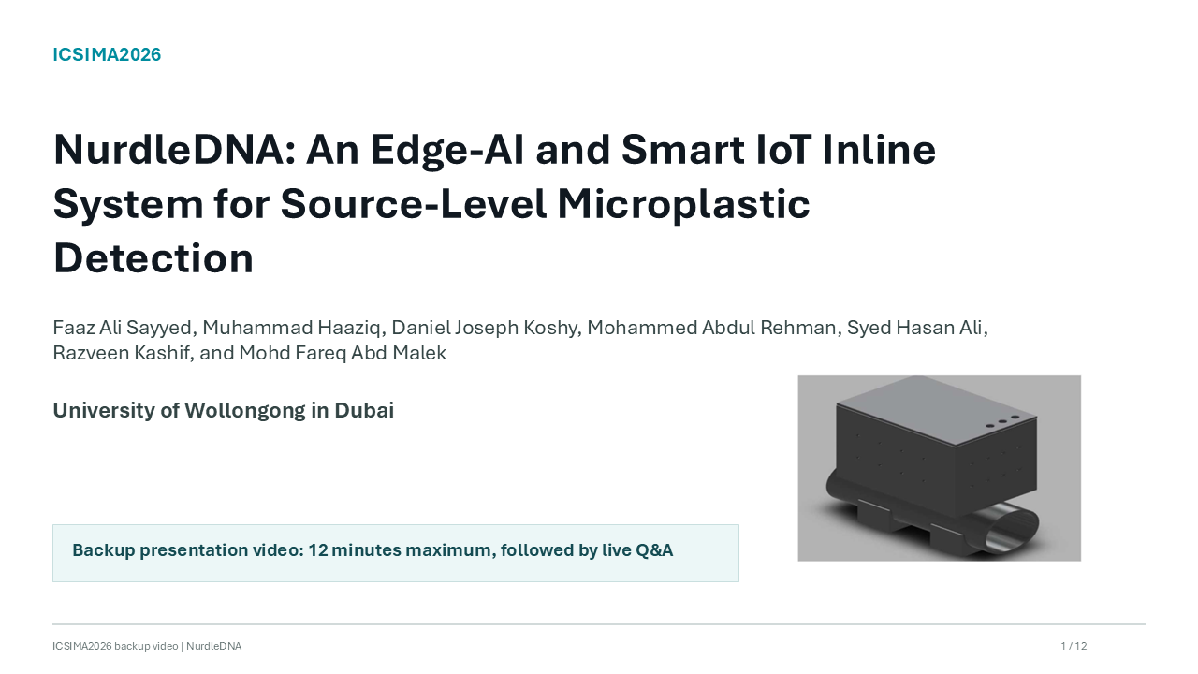
Presentations/ICSIMA2026_Video_Package/preview/Slide1.PNG
