Faaz17/nurdle-dna/Presentations/ICSIMA2026_Video_Package/preview/Slide3.PNG

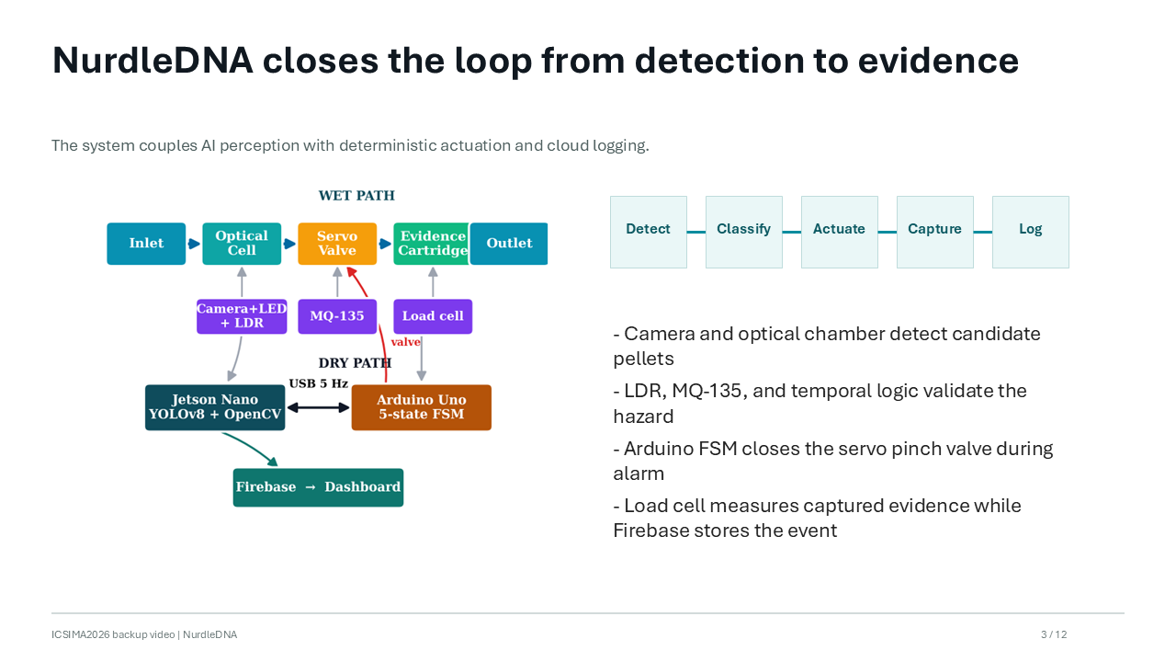
Presentations/ICSIMA2026_Video_Package/preview/Slide3.PNG
