Faaz17/nurdle-dna/Presentations/ICSIMA2026_Video_Package/preview/Slide5.PNG

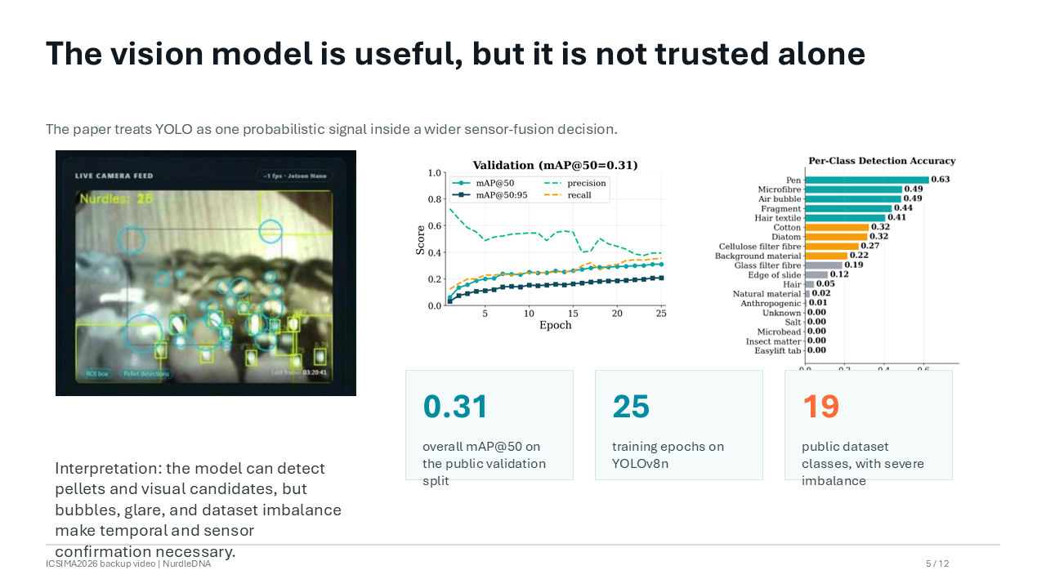
Presentations/ICSIMA2026_Video_Package/preview/Slide5.PNG
