Faaz17/nurdle-dna/Presentations/ICSIMA2026_Video_Package/preview/Slide8.PNG

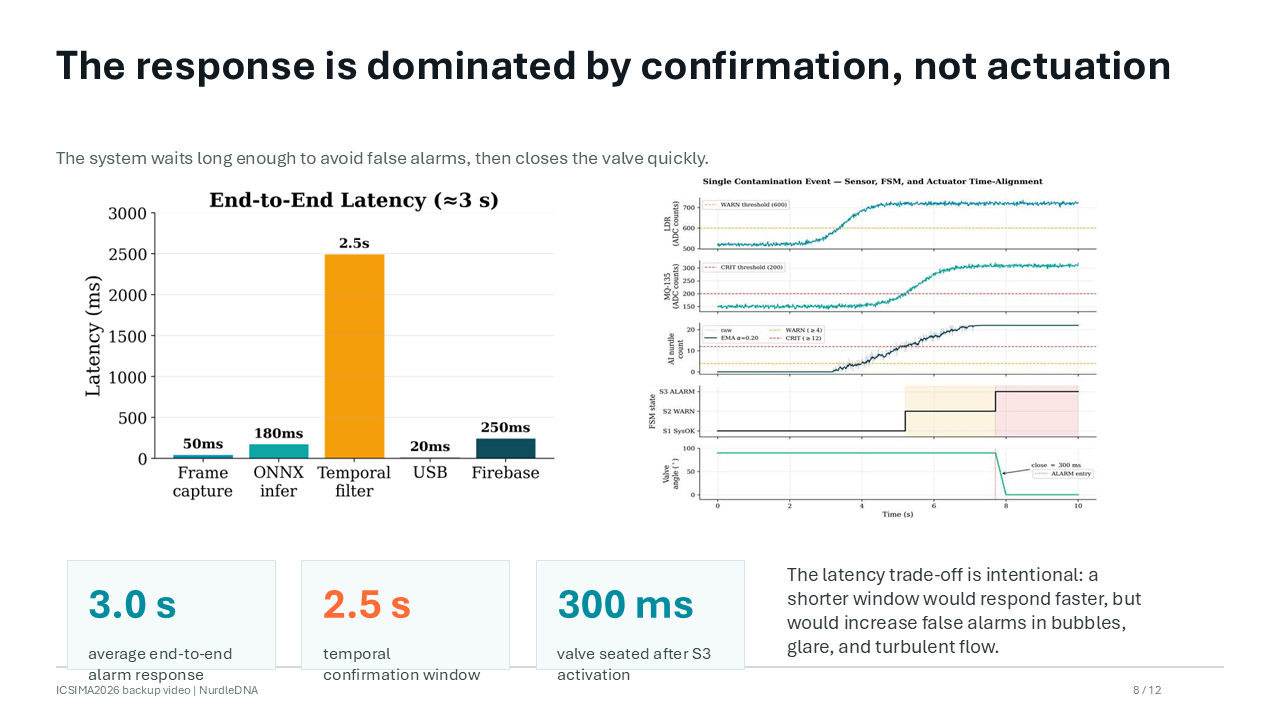
Presentations/ICSIMA2026_Video_Package/preview/Slide8.PNG
