Faaz17/nurdle-dna/Presentations/ICSIMA2026_Video_Package/preview_clean_contact_sheet.png

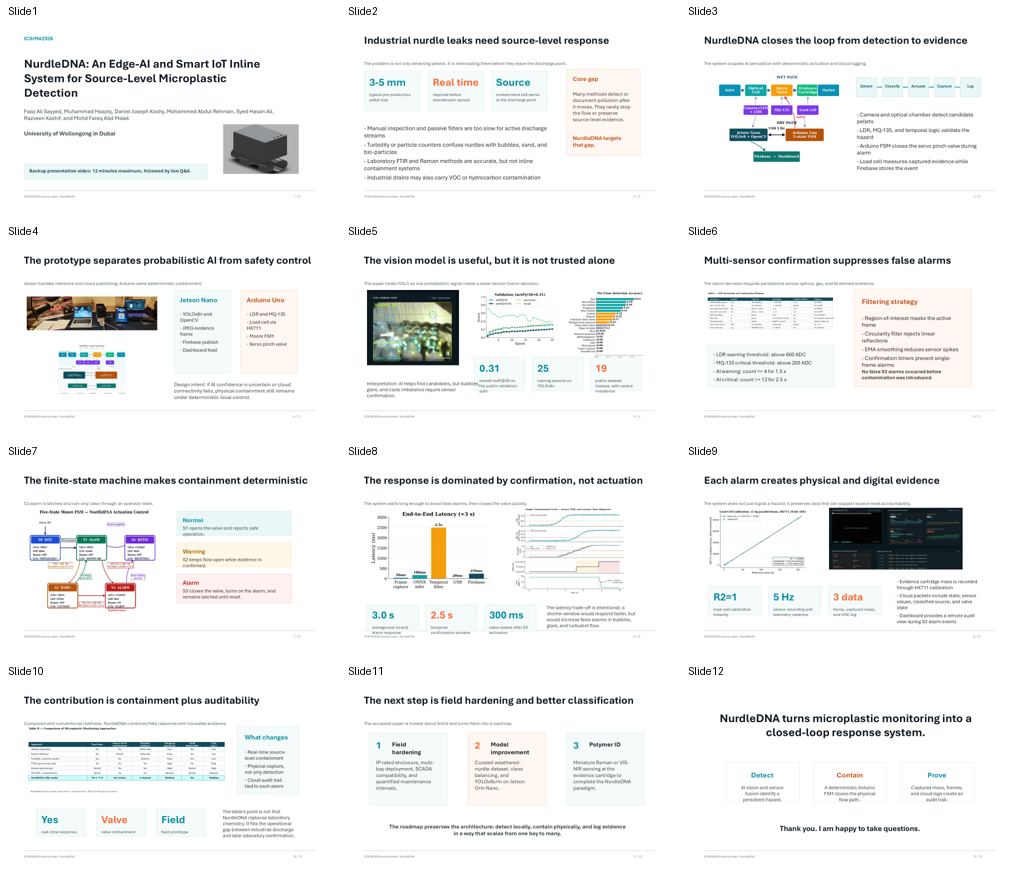
Presentations/ICSIMA2026_Video_Package/preview_clean_contact_sheet.png
