Faaz17/nurdle-dna/Website/assets/dubai-coast-cleaner-future.png

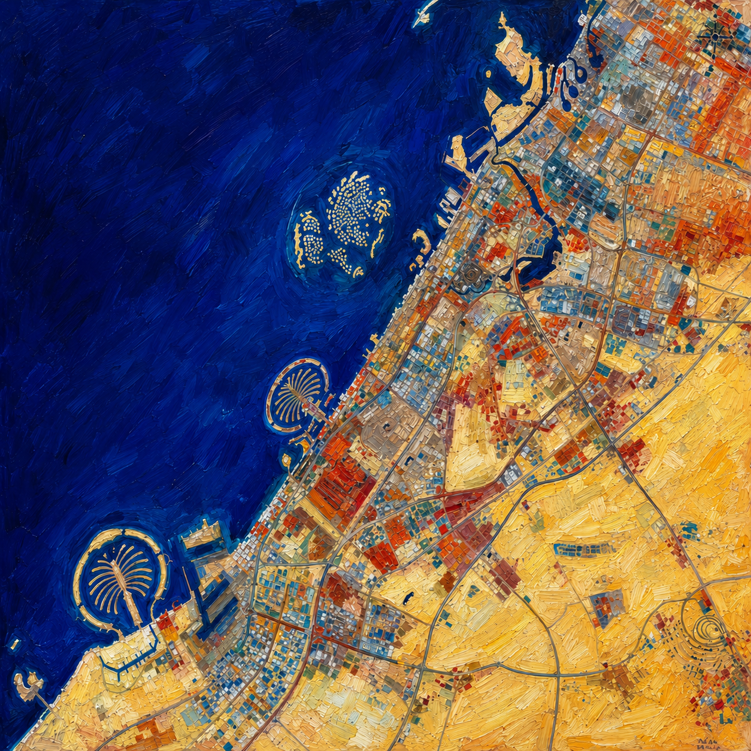
Website/assets/dubai-coast-cleaner-future.png
