Faaz17/nurdle-dna/Website/assets/industrial-refinery-cleaner-future.png

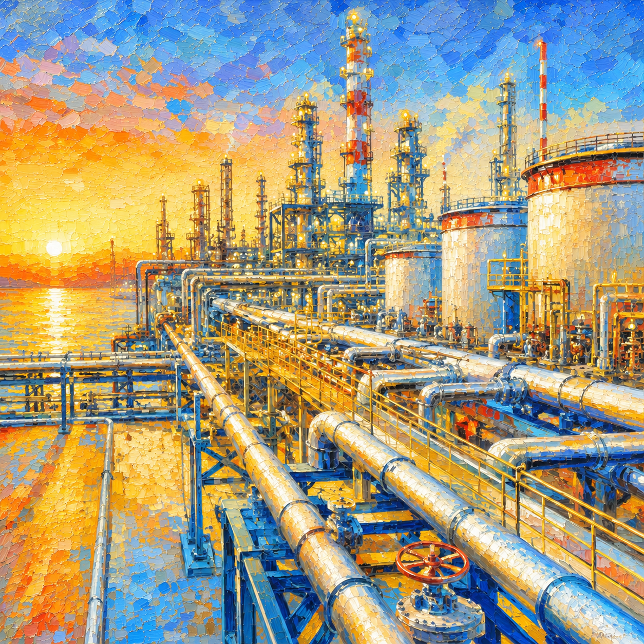
Website/assets/industrial-refinery-cleaner-future.png
