Faaz17/nurdle-dna/Website/assets/letters/bcl.png

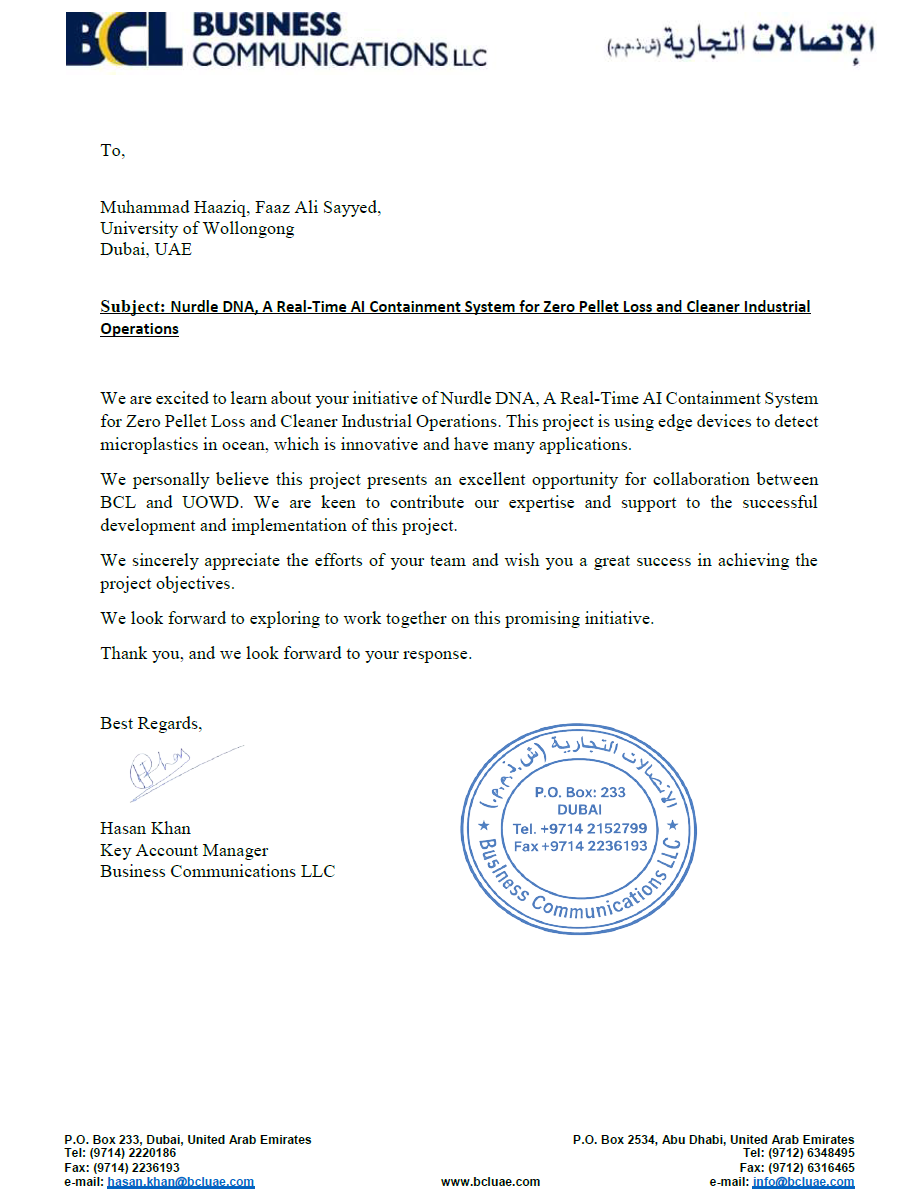
Website/assets/letters/bcl.png
