Faaz17/nurdle-dna/Website/assets/letters/prismix.png

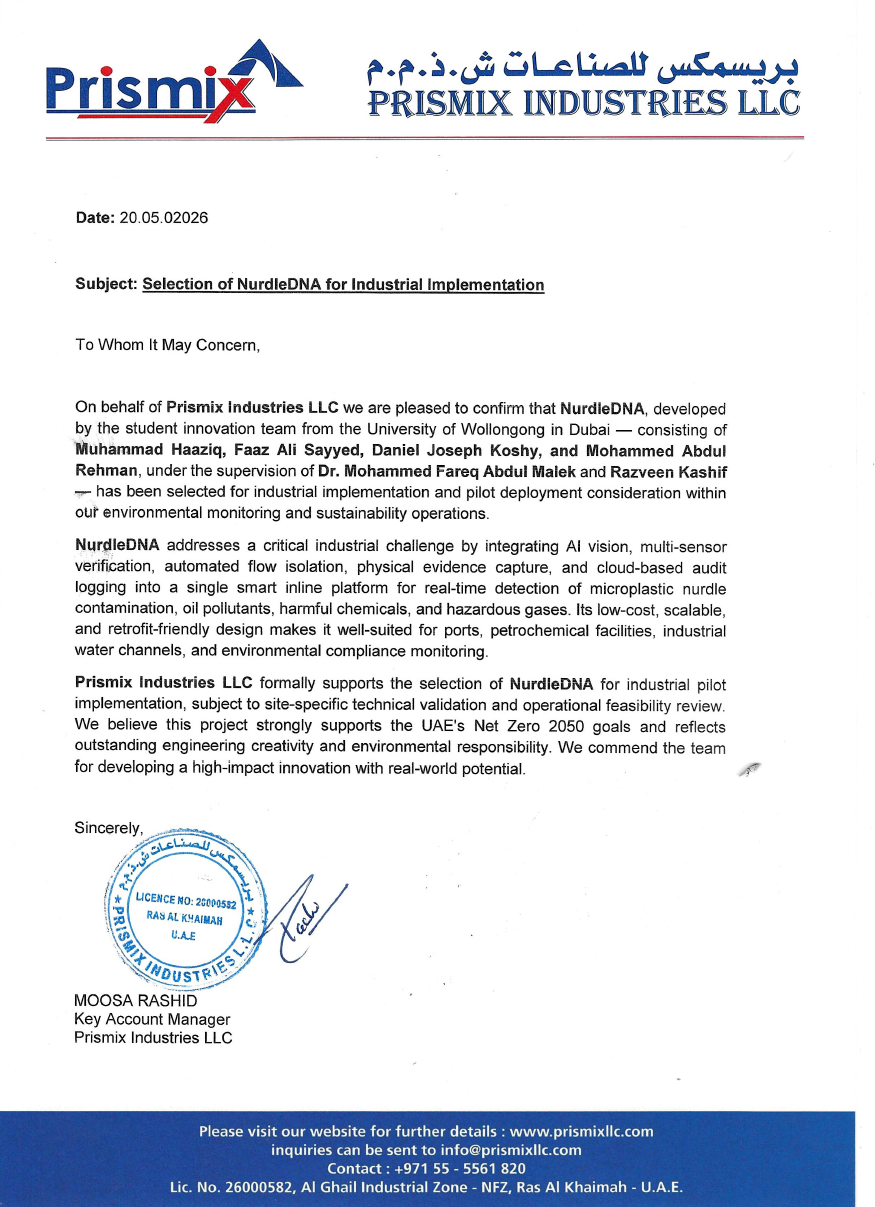
Website/assets/letters/prismix.png
