Faaz17/nurdle-dna/Website/assets/models/nurdle-dna-device.stl

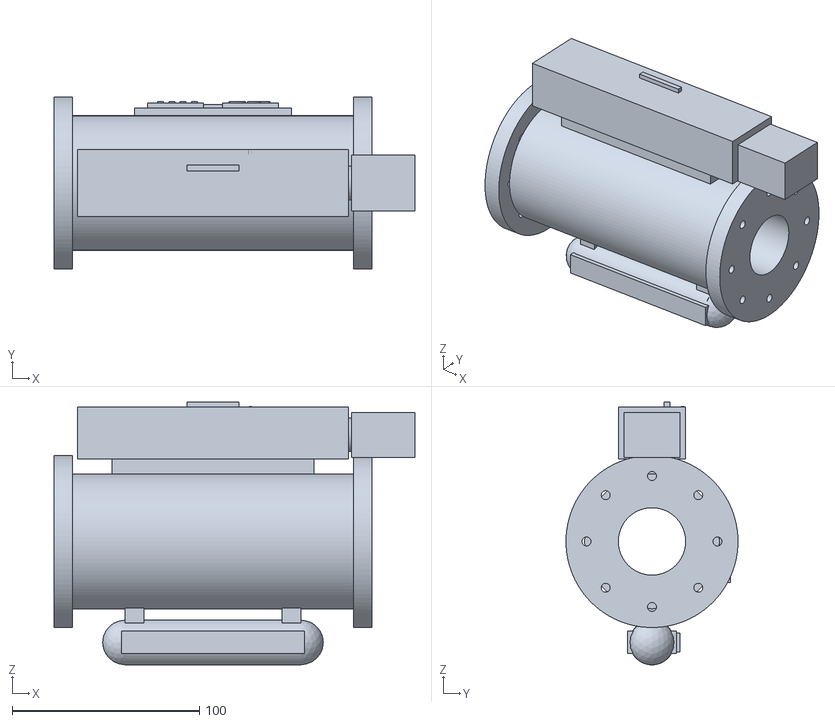
[picture p108: CAD file, 2026-05-09]
Website/assets/models/nurdle-dna-device.stl
193.0 x 92.0 x 140.5
