Faaz17/nurdle-dna/Paper Figures/real_run/results.csv

epoch | time | train/box_loss | train/cls_loss | train/dfl_loss | metrics/precision(B) | metrics/recall(B) | metrics/mAP50(B) | metrics/mAP50-95(B) | val/box_loss | val/cls_loss | val/dfl_loss | lr/pg0 | lr/pg1 | lr/pg2
1 | 55.5865 | 2.13014 | 3.5653 | 1.4007 | 0.72617 | 0.12291 | 0.06264 | 0.0312 | 2.11531 | 2.48851 | 1.35459 | 0.000143934 | 0.000143934 | 0.000143934
2 | 105.575 | 2.10233 | 2.17393 | 1.30653 | 0.65135 | 0.16384 | 0.13477 | 0.07503 | 2.02206 | 1.83327 | 1.27389 | 0.000277492 | 0.000277492 | 0.000277492
3 | 155.958 | 2.03581 | 1.79772 | 1.28867 | 0.58414 | 0.19822 | 0.1566 | 0.08987 | 1.98856 | 1.62449 | 1.26243 | 0.000399566 | 0.000399566 | 0.000399566
4 | 206.002 | 1.96976 | 1.61359 | 1.26053 | 0.55219 | 0.20081 | 0.18582 | 0.10801 | 1.92178 | 1.49615 | 1.24813 | 0.000383322 | 0.000383322 | 0.000383322
5 | 256.071 | 1.95342 | 1.53533 | 1.25823 | 0.48744 | 0.22922 | 0.19986 | 0.11257 | 1.89527 | 1.44056 | 1.22234 | 0.000366096 | 0.000366096 | 0.000366096
6 | 306.626 | 1.9211 | 1.48232 | 1.23961 | 0.51333 | 0.22854 | 0.20459 | 0.1204 | 1.8643 | 1.41063 | 1.22687 | 0.00034887 | 0.00034887 | 0.00034887
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
