Faaz17/nurdle-dna/Paper Figures/real_run/results.png

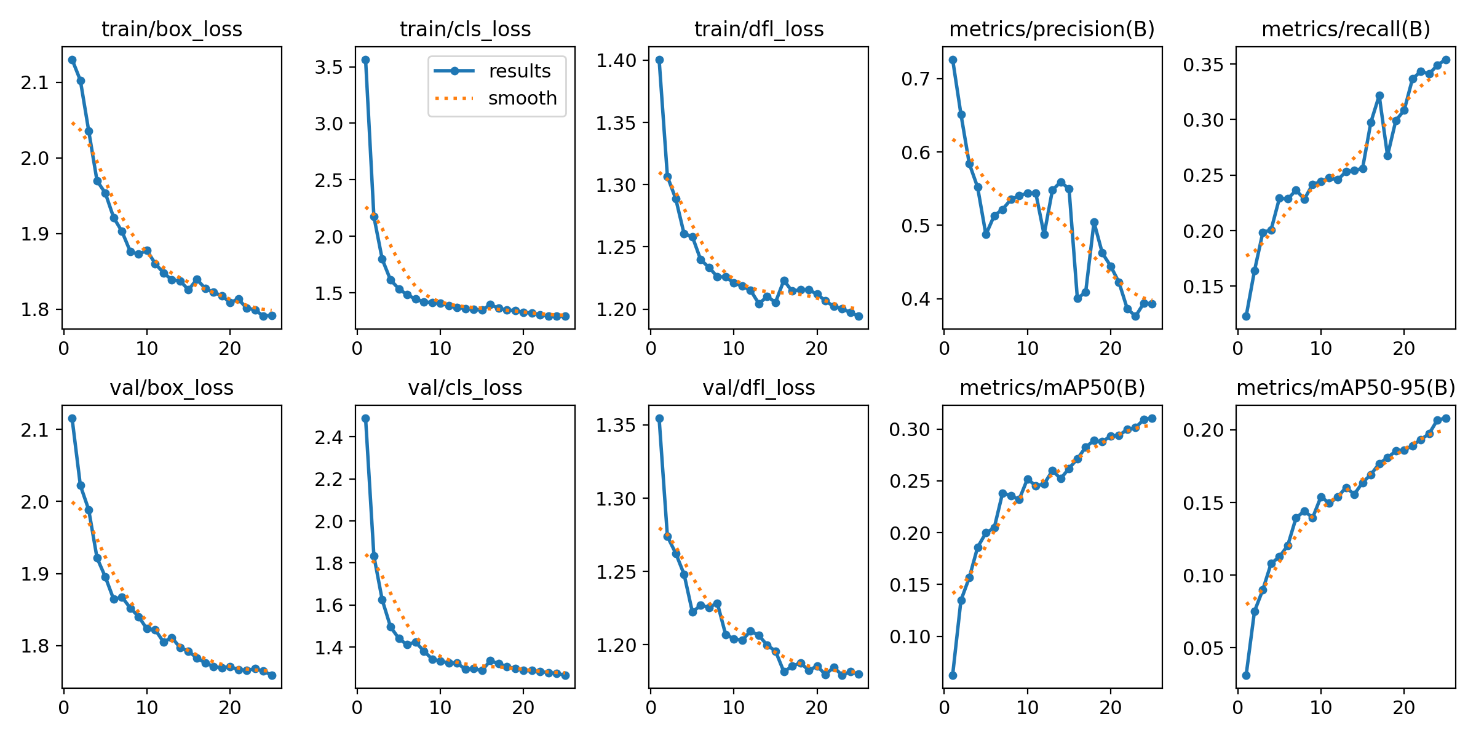
Paper Figures/real_run/results.png
