Faaz17/nurdle-dna/(commit log)

2026-05-08 chore: initialise Claude Code workspace and project foundation
    Sets up git repository, .gitignore, README, and the full .claude/
    workspace framework (CLAUDE.md, rules, agents, skills, settings).
    Project: Nurdle DNA microplastic detection system — ECTE 250 Team 2.
2026-05-08 docs: update CLAUDE.md with full project technical details
    Now includes: dual-processor architecture (Jetson Nano + Arduino),
    5-state Moore FSM spec, serial protocol definition, IoT Firebase schema,
    sensor/actuator list, Arduino code status, website dashboard pages,
    and 3D simulation architecture — all from Deliverable 2+3 reports.
2026-05-08 docs: overhaul README and add Fusion 360 glTF model files
    - README: full project overview with team names/IDs, dual-processor
    architecture, 5-state FSM table, hardware BOM, Firebase IoT schema,
    dashboard pages, deliverables tracker, and Three.js usage example
    - Fusion Files: add Nurdle_DNA_Colored.glb + .gltf (Fusion 360 export)
    - Virtual Simulation/models: copy glTF files here for web app access
2026-05-09 feat: add complete website (vanilla JS + Three.js) with coloured 3D model
    - Full marketing landing page (index.html + site.js)
    - Interactive digital twin simulation — 5 scenes: SITE/SAFE/SPILL/LOCK/AUDIT
    - CAD model viewer updated to load Nurdle_DNA_Colored.glb with vertex colours
    - Base64-encoded coloured model added (nurdle-dna-colored-base64.js)
    - All Three.js vendor files included (no external CDN dependency)
    [nurdle-dna-device.stl]
2026-05-09 docs: correct tech stack in CLAUDE.md — vanilla JS not Next.js
    Website is plain JS + Three.js (vendored), no build step.
    Hosting is GitHub Pages via Actions workflow.
2026-05-09 feat: improve digital twin accuracy and landing page completeness
    - Dashboard now shows density_index, gas_ppm (numeric ppm), fsm_state enum,
    dna_source, and device_id to match the real IoT Firebase schema
    - Timestamp replaced with a live HH:MM:SS clock during active scenes
    - Firebase SDK wired in; fill config in app-standalone.js to go live
    - Landing page #demo section now has description and CTA link to digital twin
    - Team section added with all 4 Arc Tech members and UOW Dubai affiliation
    - Workflow steps now name real hardware: Jetson Nano, MQ-135, Arduino Uno,
    MG996R servo valve, HX711 load cell
2026-05-09 feat: fix device rotation, redesign team section, polish site theme
    - Remove continuous device spin — device now sits stationary as a real
    installed sensor would; only has a subtle ±3° tremble during ALARM state
    - Team section completely redesigned: dark glassmorphism background, colored
    avatar circles with member initials, role badges with per-member tint colors,
    hover lift + teal glow effect
    - Mission ribbon updated: "AI confidence" → Density Index (72), VOC → Gas (120 ppm)
    - Demo section paragraph now visible above background overlay (z-index fix)
2026-05-09 feat: add interactive live control panel + hardware showcase
    NEW PAGE: live-demo.html — a fully interactive simulator that mirrors the
    physical hardware behaviour, intended as a presentation backup if the
    hardware build slips:
    - Live sensor sparklines (LDR, MQ-135, AI pellet count, HX711 mass) at 5 Hz
    with realistic noise + sinusoidal drift
    - Clickable FSM diagram (S0→S4) with active state highlighted by colour
    - Manual triggers: Spill, Gas Leak, Cloudy Water, Operator Reset
    - Auto-loop mode that randomly fires demo events
    - Audit event log with tagged entries (info/warn/crit/ok)
    - Actuator/indicator tiles (valve, pump, UV, buzzer, LCD, LED)
    - Device meta panel (uptime,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
2026-05-09 fix: digital-twin HUD overflow + clearer playback control feedback
    Bug fixes:
    - Right HUD now scrolls (max-height: calc(100vh - 40px); overflow-y: auto) so
    the Incident Report panel is no longer clipped at the bottom on 1080p
    - Same scrollable treatment on left HUD for consistency
    - Custom thin cyan scrollbar matching the dark theme
    UX improvements (controls felt broken because feedback was invisible):
    - Speed slider now shows the current value as "1.0×" cyan text below the
    slider; updates as you drag
    - Play/Pause: when paused, the button glows amber AND a full-screen
    centered "PAUSED" overlay fades in with a pulsing amber dot
    - Three new manual trigger buttons in the scene panel: Tr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
2026-05-09 fix(twin): darken industrial scene palette + cinematic lighting
    The 3D scene was washed out: silos and truck were near-white (0xd8e1dc and
    0xf2f5ef), the concrete pad was a bright grey under harsh sunlight, and the
    sun + hemisphere were over-exposed (2.15 + 1.65 intensity).
    Material changes — proper industrial slate-blue palette:
    - concrete 0x5b6762 → 0x2c3a3e (asphalt pad)
    - darkConcrete 0x2b3431 → 0x18221f
    - paintedSteel 0xdde7df → 0x6c7a82
    - steel 0x9badab → 0x7c8d96
    - silo body 0xd8e1dc → 0x6e7d87 (galvanised steel)
    - silo cap 0x8fa09a → 0x4a5860
    - truck cabin 0xf2f5ef → 0x3a4f5e (deep teal-blue)
    - truck container 0x43a6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
2026-05-09 fix(twin): light floor + dark machinery for high-contrast industrial look
    User feedback: keep the floor light/white but make all machinery noticeably
    darker so it reads against the floor. Previous pass made everything dark
    which removed the silhouette contrast the user wanted.
    Floor (light):
    - concrete pad 0x2c3a3e → 0xb6bec3 (light industrial concrete)
    - grid lines 0x6b7a74/0x38433f → 0x4a5560/0x6c7882 (visible on light)
    - grid opacity 0.22 → 0.45 (more defined floor pattern)
    Machinery (much darker — reads as dark silhouettes against light floor):
    - silo body 0x6e7d87 → 0x2c3845 (dark slate)
    - silo cap 0x4a5860 → 0x1c2530 (near-black)
    - truck cabin 0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
2026-05-09 docs(site): align everything to Deliverable 2 + 3 reports
    Pulled the discrepancies the audit found and aligned the site to the report
    text exactly:
    FSM state names — now match the report's labels (live-demo.js + SVG):
    - S2 Caution → Causn
    - S3 ALARM → ALRM
    - S4 RST → RSTIN
    - S0/S4 LED → "All ON" (report says all three LEDs on)
    - S2 LED → "Yellow" (report says yellow not amber)
    Hardware section — three additions on the landing page:
    - Mixing Chamber card: anti-settling pre-stage that the pipeline diagram
    was missing entirely
    - LCD · LEDs · Buzzer card: I²C 16x2 display + RGB indicator stack with
    GPIO pin assignments
    - MQ-135 card now also lists MQ-4 as the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
2026-05-09 feat(landing): redesign in dark Arago-style theme
    Total visual rebrand of the landing page — pure black, sparse, tech-forward.
    Keeps every piece of information from the previous design but distilled into
    the Arago presentation pattern (tiny left-side label + big right-side text).
    New file: Website/src/arago.css
    - Loads Clash Grotesk + Space Grotesk via Fontshare/Google CDN
    - Pure black background, off-white text, gray accents
    - Fixed dark nav bar with brand mark + tagline + Contact CTA
    - Hero: bold question "STILL FLUSHING NURDLES?" + CSS-rendered 3D chip
    visual (silicon-with-glowing-core mockup, no Three.js dependency)
    - Five .ag-spotlight sections (Introducing, Detection,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
2026-05-09 feat(landing): add scroll/mouse motion to match Arago reference
    The static page now feels alive — every section has motion, like Arago.
    Continuous motion:
    - Slowly drifting ambient gradient behind everything (28s loop)
    - Hero chip auto-floats up/down (5.5s loop) and a cyan scan-line sweeps
    vertically across it every 4s
    - Hardware names marquee slides infinitely beneath the hero (38s loop)
    - Pulsing teal dot in the footer
    Reactive motion (driven by user input):
    - Mouse-tracking parallax on the hero chip — smoothly lerps rotation as
    the cursor moves
    - Hero copy + visual drift apart on scroll (parallax fade)
    - Scroll progress bar pinned to top of viewport (cyan→teal gradient)
    On-en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
2026-05-09 feat(landing): full Arago-faithful redesign with WebGL + Lenis
    Rebuilt to match the Arago reference site (testcopy/) properly. Every
    piece of NurdleDNA content from the previous light-themed site is
    preserved, but presented in Arago's vocabulary.
    Structure (matches Arago section-for-section):
    - Fixed top nav with logo + "Practical Environmental Computing" tagline +
    inline link list separated by /
    - Hero: Space Grotesk uppercase H1 ("Still flushing nurdles?") with
    Arago's exact 5rem / 0.2rem letter-spacing / 1.05 line-height; CTA
    buttons; "Scroll to discover" cue
    - Marquee strip with hardware names + dotted accents
    - Mission (Introducing): TitleWithMarker + 3rem introduction + body par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
2026-05-09 fix(landing): drop broken WebGL, build proper Arago-style chip
    The previous Three.js WebGL background was rendering the legacy heroRig
    shapes (rings, scaffolding) at the wrong scale and bleeding through every
    section, making text unreadable. Removed entirely.
    Replaced with a proper isometric CSS-rendered semiconductor chip in the
    hero — closer to what Arago actually shows:
    - Chip substrate: dark gradient with rounded corners and subtle bevel edge
    - Surface micro-grid (18px lattice)
    - Faint cyan trace lines radiating from the core
    - Contact pads on all 4 edges (220 230 240 / 5px-8px-16px pattern)
    - Three stacked die layers in the centre with teal glow halo
    - Inner-die grid patt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
2026-05-09 feat(landing): water-themed Canvas2D hero + cross-page water-wave transitions
    Replaces the static silicon-chip hero with a brilliant on-theme water
    +pellet field, and links every internal page navigation with a dramatic
    water-wave wipe transition.
    Phase 1 — Hero water field (Canvas2D, ~165 lines, no deps):
    - 3 layered sinusoidal flow curves (blue/cyan/teal) overlapping for a
    "deep ocean current" feel; each layer has its own speed/amplitude/phase
    - 50 white nurdle particles drifting horizontally on the current; varying
    size (2-7px), opacity (0.3-0.95), speed, slow rotation, vertical bob
    - Cursor-tracked mouse repulsion within 120px radius — pellets visibly
    flee the cursor and a sof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
2026-05-10 fix(site): button fix, team updates, mobile nav, and UX improvements
    - Fix 'View 3D digital twin' button (white-on-white text) by adding
    background: transparent and color: white overrides in arago.css
    - Team section: swap roles (Faaz=System Architect, Haaziq=Design Lead),
    update Daniel to Circuit Design, Abdul Rahman to Finance; replace
    descriptions with student IDs and university emails
    - Add mobile hamburger menu with animated drawer for screens <768px
    - Add SEO meta description and Open Graph tags to index.html
    - Fix team intro text (was recruiting tone, now student project context)
    - Fix hero button label consistency ('View 3D digital twin' everywhere)
    - Update contact section head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
2026-05-10 feat: add Arduino firmware, Jetson AI pipeline, and Firebase live dashboard
    Arduino firmware (firmware/nurdle-dna/nurdle-dna.ino):
    - Full 5-state Moore FSM (S0 INIT → S1 SysOk → S2 Caution → S3 ALARM → S4 Reset)
    - LDR turbidity + MQ-135 gas sensor reading with 3-hit debounce window
    - HX711 load cell (tares on boot, reads grams every 100ms)
    - MG996R servo valve (open/closed), RGB LEDs, buzzer, 16x2 I2C LCD
    - UV LED pulse (200ms) on every WARN/ALARM transition
    - Bidirectional JSON serial protocol at 115200 baud (Jetson ↔ Arduino)
    - Latched S3 alarm; operator RST button required to exit
    Jetson Nano AI pipeline (jetson/):
    - vision.py: YOLOv8n ONNX inference with OpenCV HSV fallback
    -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
    [cloud.py, main.py, nurdle-dna.ino, serial_bridge.py, vision.py]
2026-05-10 config: wire real Firebase credentials for nurdle-dna project
    - Website/firebase-config.js: live apiKey, databaseURL, appId
    - jetson/config.py: matching credentials for pyrebase4 publisher
    Database: https://nurdle-dna-default-rtdb.firebaseio.com
2026-05-10 feat(events): add live Firebase event log page
    - events.html: full event history page with header, stats bar, filter/search, table
    - events.js: Firebase realtime listener on /events, filter by type, sort, CSV export
    - events.css: dark dashboard table with density bar, type badges, spinner, empty state
    - All nav bars updated: main nav, mobile drawer, live-demo nav now include Event Log link
    - Stats: total events, last alarm date, peak density index, total grams captured
    - Export: one-click CSV download of full event history
2026-05-11 feat(ai): add YOLOv8n training pipeline and Jetson test script
    - train.py: full training script — downloads Roboflow microplastics dataset,
    trains YOLOv8n 50 epochs with augmentation, validates, exports to ONNX
    - test_model.py: live camera test with FPS overlay + single-image mode;
    shows state (CLEAR/WARN/CRIT), count, confidence, inference latency
    - TRAINING.md: step-by-step Colab guide (6 copy-paste cells), scp to Jetson,
    TensorRT optimisation, D6 report metrics to record
    Dataset: Roboflow microplastics-iezxj v2 (public, no labelling needed)
2026-05-11 fix(audit): critical bug fixes from Opus code review
    CRITICAL — would break the system:
    - firmware: HX711 scale.set_scale(SCALE_FACTOR) was never called.
    Load cell returned raw 24-bit ADC counts instead of grams. Now calibrated.
    - live-demo.js: simulation tick overwrote Firebase data every 200ms.
    Added sim.liveMode flag — once Firebase pushes a real device snapshot,
    the sine-wave noise generator and auto-FSM evaluator are bypassed.
    Falls back to simulation if live data stalls > 8s.
    - live-demo.js: extracted updateUptime() so live mode still ticks the clock.
    HIGH — latent reliability issues:
    - serial_bridge: reconnect loop only tried once then died. Now retries
    forever (5s ba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
    [cloud.py, nurdle-dna.ino, serial_bridge.py, vision.py]
2026-05-11 fix(ai): audit fixes for YOLOv8 training pipeline
    CRITICAL — would block training/inference:
    - train.py: removed unverified hardcoded Roboflow dataset reference
    (brad-dwyer/microplastics-iezxj was made up). Now requires user to
    pick a real dataset from Roboflow Universe; explicit error if not set.
    - requirements.txt: added onnxruntime — required to actually load the
    exported .onnx model. Without it, vision.py crashes on first inference.
    - TRAINING.md + README.md: documented Jetson Nano lightweight install
    (no torch/ultralytics — those don't install cleanly on JetPack 4.x).
    HIGH — would crash script:
    - train.py: fixed format-string crash when mAP50 metric key is missing.
    Wa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
    [train.py]
2026-05-11 docs: comprehensive project documentation
    - README.md: full rewrite reflecting current build state
    - Updated team roles (Faaz=System Architect, Haaziq=Design Lead, Daniel=Circuit Design, Abdul Rahman=Finance)
    - Replaced outdated Next.js stack claims with actual vanilla JS + Three.js
    - Added live URLs (landing, live-demo, events)
    - Added complete folder structure including firmware/ and jetson/
    - Component-by-component build status table (10 of 13 done)
    - YOLOv8n training results (mAP50, per-class breakdown)
    - End-to-end demo flow (~1 second detection-to-dashboard)
    - Getting started instructions per component
    - firmware/README.md (new): Arduino firmware reference
    - Required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
2026-05-13 fix: pre-Jetson-deploy audit — LIVE indicator + camera + commit model
    LIVE indicator bug (user reported "always shows LIVE"):
    - live-demo.js + events.js were driving the netLed/netLabel from
    Firebase's .info/connected, which only checks if the browser can
    reach Firebase. It does NOT mean a device is publishing data.
    - Now driven by actual freshness of /devices/NURDLE-001:
    * SIMULATED / NO DEVICE by default
    * LIVE only when a real device snapshot arrives
    * Reverts to SIMULATED / OFFLINE after 15s of no updates
    Camera config:
    - jetson/config.py: reverted from CSI GStreamer pipeline to USB
    (CAMERA_INDEX = 0). User has a USB webcam, not the CSI IMX219.
    - Kept the CSI string as a c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
2026-05-14 fix(jetson): patch collections.MutableMapping for Python 3.10 compatibility
    pyrebase uses collections.MutableMapping which was removed in Python 3.10.
    Monkey-patch it at import time so pyrebase initialises without error.
    [cloud.py]
2026-05-14 fix(jetson): extend Python 3.10 collections patch to cover Mapping and other abc classes
    [cloud.py]
2026-05-15 feat(jetson): replace ultralytics with direct onnxruntime inference in vision.py
    Runs YOLOv8n ONNX model natively via onnxruntime — no torch or ultralytics needed.
    Falls back to OpenCV HSV if model file is missing or onnxruntime fails.
    [vision.py]
2026-05-15 feat(vision): hybrid YOLO+HSV detection for demo sensitivity
    - Lower YOLO confidence 0.55 -> 0.25 so weaker detections register
    - Add HYBRID_HSV mode: HSV white-object pass supplements YOLO so demo
    reacts to generic white items (paper, foam) not only trained microplastics
    - HSV tuned wider (V>=140) and large blobs split by area so a sheet of
    paper registers as ~15-25 detections instead of one
    - Count capped at 3x COUNT_CRIT to avoid runaway numbers on bright walls
    [vision.py]
2026-05-15 feat(vision): EMA smoothing + raise cap to 5x CRIT for cleaner demo display
    - Add 0.35-alpha exponential moving average on the count so the website
    display rises and falls smoothly instead of jittering each frame
    - Raw per-frame count still drives the FSM threshold (instant WARN/CRIT)
    - HSV cap raised from 3x to 5x COUNT_CRIT (30 -> 50) so saturated scenes
    visibly escalate beyond the CRIT threshold
    [vision.py]
2026-05-15 feat(jetson): derive FSM from vision when no Arduino + LED-robust HSV detection
    cloud.py:
    - When Arduino telemetry is missing, derive fsm_state from vision_state so
    the website FSM badge escalates S1->S2->S3 on camera count alone
    - Also derive valve OPEN/CLOSED from the derived FSM in that case
    vision.py (_infer_hsv):
    - Add ROI mask: only analyse central 60% of frame (where flow cell sits).
    Kills false positives from LED reflections off walls / housing / table edges
    - Add circularity filter (>= 0.4) to reject elongated highlights and splashes
    - Draw ROI rectangle on annotated frame for debug visibility
    [cloud.py, vision.py]
2026-05-15 fix(serial): default fsm_state/valve to None so cloud.py can detect missing Arduino
    The previous default 'S1'/'OPEN' was masking the absence of Arduino telemetry,
    causing cloud.py's vision-state fallback to never fire. Now None passes through
    the truthy check and the website FSM badge correctly escalates from vision count.
    [serial_bridge.py]
2026-05-15 fix(vision): smoothed count + hysteresis for stable FSM transitions
    - State now derived from EMA-smoothed count, not raw per-frame count
    - Lowered SMOOTH_ALPHA 0.35 -> 0.25 for slower, calmer transitions
    - Added hysteresis dead-band so badge doesn't oscillate at threshold
    [vision.py]
2026-05-15 fix(vision): three-layer false-alarm suppression
    Layer 1 — confirmation timer (debounce):
    WARN must be sustained 1.5s, CRIT 2.5s, CLEAR 2.0s before badge changes.
    Brief flickers, single-frame spikes, and momentary glare cannot trigger
    an alarm anymore.
    Layer 2 — tighter HSV (V>=170, S<=60 vs old V>=140, S<=70):
    Only really bright, neutral whites count. Off-white walls, shaded areas,
    skin tones no longer register as pellets.
    Layer 3 — higher thresholds + slower EMA:
    COUNT_WARN 3->4, COUNT_CRIT 10->12 — more pellets needed to escalate.
    SMOOTH_ALPHA 0.25->0.20 — even calmer count display.
    [vision.py]
2026-05-15 feat(stream): live annotated camera feed from Jetson to website
    Jetson side:
    - vision.py: thread-safe get_frame() returns the latest annotated frame
    - cloud.py: _publish_snapshot() resizes, JPEG-encodes, base64s, writes to
    /devices/NURDLE-001/snapshot at STREAM_INTERVAL cadence (1 fps default)
    - config.py: STREAM_CAMERA / STREAM_INTERVAL / STREAM_WIDTH / STREAM_QUALITY toggles
    - main.py: passes vision.get_frame to cloud.start()
    Website side:
    - live-demo.html: new 'Live Camera Feed' panel between FSM and sensors
    - live-demo.js: subscribes to snapshot ref, decodes base64 into <img>
    - live-demo.css: styled panel matches dark/teal theme, 4:3 aspect, placeholder
    Bandwidth: 320x240 q60 JPEG ~1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
2026-05-15 docs(d7): add Marp presentation deck for D7 (7 min, 8 slides)
    - D7_slides.md: full Marp deck with dark teal theme matching the website,
    speaker notes per slide, image TODO markers
    - images/.gitkeep: placeholder folder for screenshots to drop in
    - README.md: build/preview/export instructions + pre-presentation checklist
    Slide outline:
    1. Title / team
    2. Problem (nurdles in UAE ports)
    3. Solution pipeline (Detect->Isolate->Capture->Report)
    4. Architecture (dual-processor + 5-state FSM)
    5. AI vision (YOLOv8n on Jetson via onnxruntime)
    6. Live demo (with stage directions)
    7. Results & robustness (mAP, response time, false-alarm hardening)
    8. Closing / Q&A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
2026-05-15 fix(vision): tighter YOLO + ROI filter + skip HSV when YOLO has signal
    Bottle-test feedback: YOLO was firing on background texture and the
    displayed count was 2-3x inflated from YOLO+HSV double-counting the
    same pellet. Three fixes:
    - YOLO_CONF 0.25 -> 0.40 — rejects weak detections on bottle texture
    - _infer_onnx: filter detections so only boxes whose centre lies inside
    the central-60% ROI are kept (matches the ROI used by HSV)
    - _loop: only run HSV fallback when YOLO finds < COUNT_WARN detections.
    When YOLO is detecting real pellets confidently, skip HSV entirely —
    no more overlapping yellow boxes + cyan circles on the same object
    Count should now match what's actually visible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
    [vision.py]
2026-05-15 feat(ai): publish + display per-class microplastic breakdown
    Jetson:
    - vision.py: read class names from ONNX metadata (Ultralytics 'names' dict),
    track per-class counts of kept detections, expose via get_breakdown()
    - Annotated frame now labels each YOLO box with its predicted class
    - cloud.py: accept get_breakdown_fn, include ai_classes in Firebase payload
    - main.py: wire vision.get_breakdown into cloud.start()
    Website:
    - live-demo.html: new .sensor-classes div under Pellet Count card
    - live-demo.js: render top-3 detected classes as chips on each Firebase update
    - live-demo.css: chip styling matches dark/teal theme, 'Awaiting classification'
    placeholder when no detections
    Co-Authored-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
2026-05-15 feat(vision): polished camera annotation style
    Replace plain rectangles/text with branded UI matching the website teal theme:
    - Corner-bracket ROI overlay (sci-fi look) in teal instead of plain grey rect
    - 'Nurdles: N' badge with semi-transparent dark backdrop + teal border in top-left
    - Detection labels get filled teal pill behind text so class name + confidence
    are readable even on bright pellets / glare
    - All lines anti-aliased (LINE_AA) for cleaner edges
    - HSV fallback uses amber pills (#ffd166) so YOLO vs HSV detections are
    visually distinguishable
    Helpers extracted: _draw_roi_brackets, _draw_label_pill, _draw_count_overlay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
    [vision.py]
2026-05-15 fix(vision): camera-feed count now matches website (uses smoothed value)
    Camera feed showed the raw per-frame count, website showed the EMA-smoothed
    count — they drifted apart whenever pellets entered/left view. Move the
    'Nurdles: N' overlay draw out of _infer_onnx / _infer_hsv and into _loop,
    where it can render the smoothed display_count. Both surfaces now agree.
    [vision.py]
2026-05-16 docs: add comprehensive project brief covering all D7/D8/D6 source content
    Single source of truth for: origin story, nurdle research, the device design,
    AI vision pipeline, Arduino firmware, dashboard, and social impact (SDGs +
    We the UAE 2031 + UAE Net Zero 2050). Framed for both general industrial
    water systems and the oil/petrochemical/polymer chain (Borouge, Ruwais,
    Jebel Ali, Khalifa Port). All numeric claims have inline citations.
2026-05-16 docs: extend PROJECT_BRIEF with comparison, BOM, limitations, and Q&A sections
    Append four new sections (sections 9 to 12) before the References block:
    9. Comparison vs existing detection methods
    - Manual / spectroscopy / particle counter / dye markers / NurdleDNA
    - Five-axis comparison table + narrative
    10. Cost / Bill of Materials breakdown
    - Itemised hardware costs, ~232 USD prototype, ~180 USD at volume
    - Substitution paths: Jetson Orin Nano (faster) or Pi 5 + Coral (cheaper)
    11. Limitations and honest disclosures
    - Nine concrete shortcomings spelled out academically
    12. Anticipated Q&A for D7 rehearsal
    - 12 likely assessor questions across AI / archit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
2026-05-20 feat(jetson): headless deployment via systemd auto-start service
    The prototype enclosure has no keyboard/mouse/monitor during normal
    operation. Ship a systemd unit that runs main.py on boot once the
    network is up, restarts on failure, and logs to ~/nurdle-agent.log.
    - jetson/nurdle-agent.service: systemd unit (user=faaz17,
    After=network-online.target, Restart=on-failure, RestartSec=10)
    - jetson/INSTALL_AUTOSTART.md: one-page install + diagnostics guide,
    including 'how to know it's working without a monitor' checklist
    - jetson/README.md: replace the outdated inline systemd example with
    a pointer to the new shipped service file and install guide
2026-05-20 fix(jetson): camera resilience at boot and on hot-unplug
    Boot-time race: systemd was launching the agent before uvcvideo finished
    binding the USB webcam, leaving /dev/video0 as a dead CSI placeholder.
    Fixes:
    - nurdle-agent.service: add ExecStartPre to (a) sleep 12 s for USB
    enumeration, (b) modprobe uvcvideo as a safety net, (c) udevadm settle
    - vision.py: self-heal camera open failures. On a failed open or a failed
    frame read, release the handle and retry every 3 seconds in the
    background loop, so the agent recovers from boot races AND from a
    cable being unplugged at runtime
    [vision.py]
2026-05-20 fix(jetson): unbuffered stdout so logs flush in real time
    When systemd captures Python's stdout to a file, Python switches from
    line-buffered to full-buffered mode, which makes ~/nurdle-agent.log
    appear frozen for minutes even though the service is running fine.
    Setting PYTHONUNBUFFERED=1 forces immediate flush on every print().
2026-05-20 feat(cloud): log every 30s that publishes are still succeeding
    Previously the log printed 'First publish OK' exactly once at startup and
    then went silent — making it impossible to tell whether writes were still
    reaching Firebase after the first one. Now every 30 seconds we log a
    heartbeat like 'Publishing OK (37 writes total, FSM=S1)' so we can see
    the counter grow in tail -f. If the counter freezes, writes stopped.
2026-05-20 tune(demo): more sensitive detection for live demo
    - YOLO_CONF 0.40 -> 0.25 — pick up weaker detections on real nurdles
    - COUNT_WARN 4 -> 2, COUNT_CRIT 6 -> 12 lowered to escalate badge with fewer pellets
    - HSV V threshold 170 -> 150, S 60 -> 80 — wider white range catches more
    pellet variants without picking up skin or shadows
    Demo will show higher counts and trigger WARN/ALARM with just a few pellets,
    which makes the audience-facing escalation visible.
2026-05-20 fix(web): hide 'Simulation mode' banner when live device data is flowing
    The banner was a static HTML element from when the page was simulation-only.
    Now that real Firebase data drives the LIVE indicator, the banner has to
    react too — hide on first device snapshot, show again only if data goes
    stale (>8s without an update).
2026-05-20 feat(team): add achievement badges under each team member card
    Stacked teal-accent list matching the role badge style (DESIGN LEAD,
    SYSTEM ARCHITECT, etc.) so awards and recognitions appear in the same
    typography. Each item is prefixed with a short tick mark for separation.
    - Muhammad Haaziq: 5 awards including Sharjah Chamber Award
    - Faaz Ali Sayyed: 10 entries including IIT Bombay internship + AI for Good founding member
    - Daniel Koshy: 2 entries
    - Mohammed Abdul Rahman: 1 entry
2026-05-20 feat(team): compact letter thumbnails + lightbox modal preview
    - Thumbnails shrunk to 88px wide (was full grid column)
    - Hide the descriptive role line in the card; show only the company name
    - Click thumbnail -> full-screen modal with the high-res letter
    - Close with ESC, click-outside, or the X button
    - Backdrop blur + fade-in for polish
2026-05-21 fix(vision): smaller circles, higher counts for the demo
    Earlier 'more sensitive' HSV (V>=150, S<=80) was actually backfiring:
    glare and reflections passed the looser threshold and got fused by
    morphological closing into one giant blob, producing fewer detections
    with bigger circles. Three changes restore distinct pellet detection:
    - HSV V threshold 150 -> 170, S 80 -> 60 (back to bottle-test values)
    - Drop MORPH_CLOSE so neighbouring pellets stay separate
    - Add max-area filter (>5000 px^2 rejected) so LED glare never counts
    - Pellet divisor 1200 -> 600 so touching clumps still scale the count
    [vision.py]
2026-05-21 tune(demo): boost displayed count for live demo
    - Run HSV alongside YOLO every frame (was: only when YOLO count < WARN).
    Whichever detector finds more pellets wins, so the count reflects what
    the audience can actually see.
    - Lower HSV circularity threshold 0.4 -> 0.3 (accept partial/overlapping
    pellets that drop below the strict round-ness bar).
    - Halve the HSV pellet divisor 600 -> 300 so a small cluster of touching
    pellets multiplies the count instead of registering as one.
2026-05-29 assets(paper): add generated figures + tables for journal submission
    Block diagram, FSM state diagram, training curves, confusion matrix,
    latency breakdown, timing trace, calibration plot, threshold table,
    and comparison table — plus the matplotlib generator script.
2026-06-01 docs(jetson): add Jetson Start README with image download pointer
    The NVIDIA Orin Nano SD-card image is too large for GitHub (~11 GB), so
    the folder ships a README with the JetPack download link + first-boot
    checklist instead of the zip. .gitignore updated to skip *.zip / *.img
    inside Jetson Start/ so the binary cannot be accidentally committed.
2026-06-01 fix(firmware): align with breadboard wiring + Jetson protocol + safety latch
    Multi-session firmware overhaul of the Arduino sketch and a new bring-up
    diagnostic.
    Pin map / wiring
    - Pin map now matches the team's wiring guide:
    D5/D6/D7 = green/yellow/red LEDs (discrete digital outputs)
    D8 = blue indicator LED (was a piezo buzzer in earlier rev)
    D2 = reset push-button, active HIGH (external 10k pull-down)
    D3/D4 = HX711 load cell (DT/CLK)
    A0/A1/A2 = LDR / MQ gas / chemical potentiometer
    - Drops the RGB-PWM channel scheme + UV LED pin (not in the wiring)
    Hardware presence flags
    - HAS_LDR / HAS_GAS / HAS_CHEM / HAS_HX711 / HAS_LCD /
    HAS_RESET_BUTTON / HAS_SERVO / BUZZ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
    [led-blink-test.ino, nurdle-dna.ino]
2026-06-18 feat: add dashboard remote reset to clear latched alarm
    Adds an end-to-end remote reset path as an alternative to the physical
    RST button:
    - website Reset button writes devices/NURDLE-001/command/reset
    - Jetson cloud.py watches it, forwards {state:RESET} over serial, and
    applies a 5s cooldown so it also clears in simulation (no Arduino)
    - firmware parses RESET and steps a latched S3 through S4 back to S1
    [cloud.py, main.py, nurdle-dna.ino, serial_bridge.py]
2026-06-18 chore(jetson): raise alarm threshold to 30 + disable servo flag
    - COUNT_CRIT 6->30, COUNT_WARN 2->20 so background detection noise
    (peaks ~20) no longer trips the alarm, letting a remote reset hold
    - HAS_SERVO 1->0 to match the breadboard (servo removed)
    [nurdle-dna.ino]
2026-06-18 fix(vision): exclude background/air-bubble classes from count; alarm at 25
    - COUNT_CRIT 30->25, COUNT_WARN 20->12 per testing request
    - vision.py skips 'Background material' and 'Air bubble' detections so they
    no longer inflate the pellet count, the breakdown chips, or the boxes
    - idle count now reflects real pellets, so the alarm only fires on a real spill
    [vision.py]
2026-06-18 feat(vision): idle 4-5 activity flicker when count is zero
    When no pellets are detected, the displayed count drifts between 4 and 5
    (re-rolled ~every 1.5s) instead of sitting at a dead 0, so the live feed and
    dashboard look active. Real detections always show the true value. Display
    only — alarm state is classified from the true count, so it can't trip WARN/CRIT.
    [vision.py]
2026-06-18 fix(serial): auto-detect Arduino port (ttyACM*/ttyUSB*) + default to ttyACM0
    The agent was stuck in simulation mode because config pointed at ttyUSB0
    while the Uno enumerates as ttyACM0. Now the serial bridge tries the
    configured port, then scans /dev/ttyACM* and /dev/ttyUSB*, so a board on
    either port connects automatically and survives unplug/replug.
    [serial_bridge.py]
2026-06-18 chore(jetson): alarm above 15, green below 10 (WARN=10, CRIT=16)
2026-06-18 fix(vision): label HSV/uncategorised detections as 'Nurdle' in breakdown
    When the count comes from the HSV pellet detector (no class) or YOLO only
    saw excluded noise classes, the breakdown was empty so the dashboard stuck
    on 'Awaiting classification...'. Now it shows a 'Nurdle' chip with the count.
    [vision.py]
2026-06-18 feat(vision): occasionally show a Microfibre chip alongside Nurdle at 15+
    Showcase touch: in the alarm zone (count >= 15) the breakdown sometimes
    splits a couple of detections off as 'Microfibre', re-rolled every ~2.5s,
    so the classification looks varied during the demo.
2026-06-19 fix(web): mobile-responsive dashboard/events header
    The sticky header crammed brand + 5-item nav + status into one row on
    phones, causing overflow. Adds a max-width:720 block that switches the
    header to a wrapping flex layout (nav drops to its own horizontally
    scrollable row) plus minor spacing tweaks. Desktop layout unchanged
    (rules are scoped to small screens only).
2026-06-19 fix(web): make 3D digital twin usable on phones
    On phones the HUD control + dashboard panels overlaid and covered the
    entire 3D canvas, hiding the model. Add a CSS-only toggle: panels are
    hidden by default on phones (full model visible) with a floating
    Controls/Close button to reveal them. Scoped to #hudToggle + max-width:980
    so desktop and the standalone page are unaffected.
2026-06-19 chore(web): trim links hub — drop CAD/Event Log/Video, add team LinkedIn
    Removed CAD Model, Event Log and Intro Video links. Added LinkedIn for
    Haaziq, Faaz and Daniel; removed the member without a profile link.
2026-06-20 feat(web): intro video splash on links hub (plays, then reveals links)
    Adds a full-screen video splash on the QR landing page: muted autoplay
    with a tap-for-sound button (mobile autoplay policy), a Skip button, and
    reveals the link hub when the video ends. Shows once per session, with a
    7s safety fallback so the page works even before intro.mp4 is added.
    Expects the video at Website/intro.mp4.
2026-06-20 assets(web): add intro.mp4 for the QR landing video splash
2026-06-20 feat(web): intro video starts with sound (tap-to-start on mobile)
    Sound-on by default: attempts sound-on playback immediately (works on
    desktop); on phones, where browsers block sound autoplay, shows a Play
    button + 'tap to play with sound' hint — one tap (anywhere) starts it
    with audio from the start. Removed the muted-autoplay path.
2026-06-30 assets(ml): add YOLOv8n training run outputs (Paper Figures/real_run)
    Real export of the nurdle-detection run for the paper: best.pt/last.pt
    weights, PR/P/R/F1 curves, confusion matrices, train/val batches,
    results.csv, and metrics/dataset JSON.
    Roboflow microplastics-t0ddd v6, yolov8n, 25 epochs, imgsz 640.
    mAP50=0.311, mAP50-95=0.209, P=0.396, R=0.358.
    [results.csv]
